tonikelope/multimetreitor/Rainmeter/Multimetreitor/@Resources/rayo.png

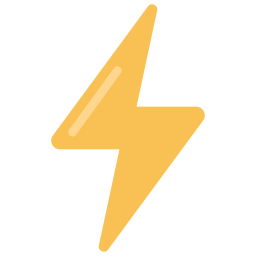
Rainmeter/Multimetreitor/@Resources/rayo.png
