tonikelope/multimetreitor/multimetreitor.ino

/**************************************************
 * MULTIMETREITOR
 **************************************************/

#include <ESP8266WiFi.h>
#include <ESP8266HTTPClient.h>
#include <WiFiClientSecure.h>
#include <PubSubClient.h>
#include <ESP8266WebServer.h>
#include <Wire.h>
#include <LiquidCrystal_I2C.h>
#include <EEPROM.h>
#include <LittleFS.h>   // DIAGNOSTIC (/fsinfo): probe the flash filesystem partition
#include <SoftwareSerial.h>
#include <PZEM004Tv30.h>
#include <ArduinoJson.h>
#include <ArduinoOTA.h>
#include <time.h>
#include <memory>
#include <stddef.h>  // offsetof (AppConfig layout static_asserts)
#include <ctype.h>   // isalnum (webhook URL encoding)
#include "secrets.h"  // WiFi credentials (not versioned — see secrets.h.example)

#ifndef TZ_INFO
// Peninsular Spain: CET with DST (last Sunday of March/October)
#define TZ_INFO "CET-1CEST,M3.5.0/2,M10.5.0/3"
#endif

const char MAIN_html[] PROGMEM = R"rawliteral(
<!DOCTYPE html>
<html>
<head>
  <meta charset='utf-8'>
  <meta name="viewport" content="width=device-width, initial-scale=1, shrink-to-fit=no">
  <title>MULTIMETREITOR</title>
  <style>
    body { font-family: 'Segoe UI', Arial, sans-serif; background: #f7f7fa; margin:0; }
    .main { max-width: 480px; background: #fff; margin: 24px auto; border-radius: 14px; box-shadow: 0 2px 16px #0001; padding: 30px 22px; }
    h1 { text-align:center; letter-spacing:2px; color:#224; margin-bottom:2px; }
    .byline { text-align:center; font-size:1em; color:#888; margin-bottom:16px;}
    .lcd-sim {
      width: calc(16ch + 1.8ch); max-width: 98vw; height: 3.2em;
      background: linear-gradient(180deg, #f7ffbf 60%, #b4ff99 100%);
      border: 3px solid #bb5; border-radius: 14px; margin: 0 auto 22px auto;
      display: flex; flex-direction: column; justify-content: center;
      box-shadow: 0 2px 12px #0002 inset;
      font-family: 'Fira Mono', 'Consolas', monospace; font-size: 1.16em; color: #111; letter-spacing: 0.8px;
      overflow: hidden; position: relative; padding-left: 0.5ch; padding-right: 0.5ch;
    }
    .lcd-row { height: 45%; line-height: 1.18em; white-space: pre; font-family: inherit; font-size: inherit; padding-left: 0; }
    .lcd-frame { position:absolute; border:2px solid #dc6; border-radius:12px; inset:0; pointer-events:none;}
    h2 { font-size:1.13em; color:#337; margin:18px 0 8px 0; border-bottom:1px solid #eef; }
    label, input[type=checkbox], input[type=radio] { cursor:pointer; }
    .section { margin-bottom: 20px; }
    .alert-row { display: flex; align-items: center; gap: 12px; margin-bottom:10px; }
    .alert-row input[type="number"] { width: 80px; }
    .pzem-spin { display:inline-flex; align-items:center; gap:6px; vertical-align:middle; }
    .pzem-spin input[type="number"] { width:92px; text-align:center; }
    .pzem-step { width:34px; height:34px; border:1px solid #bbf780; background:#eef7e2; color:#2b7a2b; border-radius:8px; font-size:1.3em; font-weight:bold; line-height:1; cursor:pointer; padding:0; }
    .pzem-step:hover { background:#e0efcd; }
    .pzem-step:active { transform:translateY(1px); }
    .alert-row .unit { margin-left:2px; color:#666; }
    .icp-group { background: #f7ffd7; border-radius:8px; padding:10px 14px; margin-bottom: 5px; border:1px solid #bbf780;}
    .icp-label { font-weight:bold; color:#2b4; }
    .icp-row { margin:4px 0 9px 0; }
    .icp-slider-label { margin-left:8px; font-size:0.97em; color:#397; }
    .icp-curve-table { margin-top:8px; width:98%; border-collapse:collapse; }
    .icp-curve-table th, .icp-curve-table td { border:1px solid #aae680; text-align:center; padding:3px 4px; }
    .icp-curve-table th { background:#eef; }
    .icp-curve-box-btn { margin-top:7px;background:#1e90ff;color:#fff;border-radius:6px;padding:5px 16px;border:none;cursor:pointer; }
    .desc { color:#555; font-size:0.98em; margin-bottom:7px; }
    .lcd-row-metrics { display: flex; flex-wrap:wrap; gap:8px; margin-bottom: 5px;}
    .lcd-row-metrics label { margin-right:7px; }
    input[type="number"], input[type="text"], input[type="range"] {
      width:85px; padding:4px; border-radius:6px; border:1px solid #ccd; margin-left:8px; font-size:1em;
    }
    input[type="range"] { width:120px; }
    .form-actions { display: flex; flex-direction: column; gap: 13px; margin-top: 25px; }
    .action-btn, input[type="submit"] {
      width: 100%;
      display: block;
      font-size: 1em;
      border-radius: 8px;
      border: none;
      color: #fff;
      padding: 13px 0;
      margin: 0;
      font-family: inherit;
      box-shadow: 0 1px 6px #0002;
      letter-spacing: 1px;
      cursor: pointer;
      transition: 0.18s;
    }
    .consumo-row {
      display: flex;
      align-items: center;
      gap: 12px;
      flex-wrap: wrap;
      margin-bottom: 8px;
    }
    .consumo-unidad {
      display: flex;
      align-items: center;
      gap: 6px;
    }
    .consumo-row input[type="number"] {
      width: 85px;
      margin-left: 0;
    }
    .action-btn.energy { background: #0ab06b; }
    .action-btn.energy:hover { background: #086c49; }
    .action-btn.eeprom { background: #ba00b4; }
    .action-btn.eeprom:hover { background: #7b006e; }
    .action-btn.reset { background: #f74; }
    .action-btn.reset:hover { background: #c33; }
    input[type="submit"] { background: #357aff; }
    input[type="submit"]:hover { background: #1c54b2; }
    .action-btn.io { background: #2f8fbf; }
    .action-btn.io:hover { background: #216d94; }
    .mqtt-section { margin-bottom:18px;}
    .topics-list { background:#f2f2f7; border:1px solid #ddd; border-radius:6px; padding:8px 10px; font-size:0.98em; color:#226; margin:7px 0 0 0;}
    .mqtt-status { font-weight:bold; margin-left:8px;}
    .mqtt-ok { color:#090; }
    .mqtt-fail { color:#c00; }
    @media (max-width:520px) {
      .main { padding:12px 2vw; }
      h1 { font-size:1.5em; }
      h2 { font-size:1em; }
      input[type="submit"], .action-btn { padding:9px 0; width:100%; }
      .lcd-row-metrics { flex-direction: column; gap:2px;}
      .desc { font-size:0.97em; }
      .lcd-sim { width: 98vw; max-width: calc(16ch + 1.8ch); font-size: 1.03em; }
    }
    .loader {
      display:inline-block;
      width:38px; height:38px;
      border:4px solid #f3f3f3;
      border-top:4px solid #357aff;
      border-radius:50%;
      animation: spin 1s linear infinite;
      margin-bottom:10px;
    }
    @keyframes spin {
      100% { transform: rotate(360deg); }
    }
    #lastResetTime { font-weight: bold; color: #1e90ff; }

    /* ===== Tabs ===== */
    .tabbar { display:flex; gap:4px; margin:4px 0 18px 0; border-bottom:2px solid #e6e9f2; }
    .tab-btn {
      flex:1; padding:10px 6px; border:none; background:none; color:#778; font-size:1em;
      font-family:inherit; cursor:pointer; border-bottom:3px solid transparent; margin-bottom:-2px;
      font-weight:bold; letter-spacing:0.4px; transition:0.15s;
    }
    .tab-btn.on { color:#357aff; border-bottom-color:#357aff; }
    .tab-btn:hover { color:#224; }
    .rules-nav { display:flex; align-items:center; justify-content:center; gap:14px; margin:2px 0 12px 0; }
    .rules-page-btn { background:#5566cc; color:#fff; border:none; border-radius:8px; width:40px; height:32px; font-size:1.2em; font-weight:bold; line-height:1; cursor:pointer; }
    .rules-page-btn:hover { background:#3a48a0; }
    .rules-page-btn:disabled { background:#b9c0d8; cursor:default; }
    .rules-page-ind { font-size:0.92em; font-weight:bold; color:#5566a0; min-width:54px; text-align:center; font-variant-numeric:tabular-nums; }

    /* ===== Rule engine editor ===== */
    .rules-intro { color:#555; font-size:0.97em; margin-bottom:12px; text-align:justify; }
    .rule-card {
      border:1px solid #d6dcf0; border-left:4px solid #357aff; border-radius:10px;
      background:#fbfcff; padding:12px 13px; margin-bottom:14px;
      box-shadow:0 1px 5px #0001;
    }
    .rule-card.disabled { border-left-color:#bbb; opacity:0.72; }
    .rule-head { display:flex; align-items:center; gap:9px; flex-wrap:wrap; margin-bottom:9px; }
    .rule-head .rule-num { flex:0 0 auto; width:23px; height:23px; border-radius:50%; background:#5566a0; color:#fff; font-size:0.82em; font-weight:bold; display:flex; align-items:center; justify-content:center; }
    .rule-head .rname { flex:1 1 130px; min-width:110px; margin-left:0; }
    .rule-head .sw { display:flex; align-items:center; gap:5px; font-size:0.92em; color:#456; }
    .rule-del {
      background:#f4f6fb; color:#c33; border:1px solid #e2b6b6; border-radius:6px;
      width:30px; height:30px; font-size:1.1em; line-height:1; cursor:pointer; padding:0;
    }
    .rule-del:hover { background:#fde7e7; }
    .rule-block { background:#fff; border:1px solid #e7ebf5; border-radius:8px; padding:9px 10px; margin-bottom:9px; }
    .rule-block > .lbl { font-size:0.82em; text-transform:uppercase; letter-spacing:0.5px; color:#8894ad; font-weight:bold; margin-bottom:6px; }
    .rule-count { font-weight:normal; letter-spacing:0; color:#aab4c8; }
    .rule-count.full { color:#c88a56; }
    .cond-row { display:flex; align-items:center; gap:6px; flex-wrap:wrap; margin-bottom:6px; }
    .cond-row select, .cond-row input[type=number] { margin-left:0; }
    .cond-row .metric { min-width:120px; }
    .cond-row .op { width:56px; text-align:center; }
    .cond-row .cval { width:88px; }
    .cond-row .unit { color:#789; font-size:0.9em; min-width:32px; }
    .cond-del { background:none; border:none; color:#c55; cursor:pointer; font-size:1.05em; padding:2px 5px; }
    .cond-join { display:inline-flex; align-items:center; gap:6px; margin:2px 0 8px 2px; font-size:0.9em; color:#556; }
    .rule-mini-btn {
      background:#eef3ff; color:#2456c8; border:1px solid #c9d8f7; border-radius:6px;
      padding:4px 11px; font-size:0.9em; cursor:pointer; margin-top:2px;
    }
    .rule-mini-btn:hover { background:#dde8ff; }
    .action-tabs { display:flex; gap:6px; margin-bottom:9px; }
    .action-tabs button {
      flex:1; padding:7px 0; border:1px solid #c9d3ea; background:#f2f5fc; color:#456;
      border-radius:7px; cursor:pointer; font-size:0.94em; font-family:inherit;
    }
    .action-tabs button.on { background:#357aff; color:#fff; border-color:#357aff; font-weight:bold; }
    .rule-field { margin-bottom:8px; }
    .rule-field label { display:block; font-size:0.9em; color:#556; margin-bottom:3px; }
    .rule-field input[type=text] { width:100%; margin-left:0; box-sizing:border-box; }
    .rule-field-row { display:flex; gap:8px; flex-wrap:wrap; }
    .rule-field-row .rule-field { flex:1 1 130px; }
    .rule-opts { display:flex; gap:16px; flex-wrap:wrap; align-items:center; font-size:0.92em; color:#456; margin-top:4px; }
    .rule-opts label { display:inline-flex; align-items:center; gap:5px; }
    .rule-opts input[type=number] { width:60px; }
    .rule-test-btn { background:none; border:none; color:#2456c8; cursor:pointer; font-size:0.88em; text-decoration:underline; padding:0; margin-top:2px; }
    .rules-actions { display:flex; gap:10px; flex-wrap:wrap; margin-top:6px; }
    .rules-actions button { flex:1 1 140px; }
    .action-btn.rules-add { background:#5566cc; }
    .action-btn.rules-add:hover { background:#3a48a0; }
    .action-btn.rules-save { background:#0ab06b; }
    .action-btn.rules-save:hover { background:#086c49; }
    #rules-status { font-size:0.92em; margin-top:8px; min-height:1.2em; }
    #rules-status.ok { color:#0a8; } #rules-status.err { color:#c33; }
    .rule-action { border:1px dashed #cdd6ee; border-radius:8px; padding:8px 9px; margin-bottom:8px; background:#fcfdff; }
    .act-head { display:flex; align-items:center; gap:8px; margin-bottom:7px; }
    .act-num { font-size:0.8em; font-weight:bold; color:#8894ad; text-transform:uppercase; letter-spacing:0.5px; white-space:nowrap; }
    .act-head .action-tabs { flex:1; margin-bottom:0; }
    .act-del { background:none; border:none; color:#c55; cursor:pointer; font-size:1.05em; padding:2px 5px; line-height:1; }
    .rule-add-action { background:#eef3ff; color:#2456c8; border:1px solid #c9d8f7; border-radius:6px; padding:5px 12px; font-size:0.9em; cursor:pointer; margin-bottom:8px; }
    .rule-add-action:hover { background:#dde8ff; }
    .rule-foot { display:flex; align-items:center; gap:14px; flex-wrap:wrap; margin-top:2px; }
  </style>
</head>
<body>
  <div class='main' style="position:relative;">
    <button type="button" id="langBtn" onclick="toggleLang()" title="Language / Idioma" style="position:absolute;right:14px;top:14px;background:#eef;border:1px solid #ccd;border-radius:6px;padding:3px 10px;font-size:0.9em;cursor:pointer;">EN</button>
    <h1>MULTIMETREITOR</h1>
    <div class="byline">by tonikelope</div>
    <div class="lcd-sim" id="lcd-sim">
      <div class="lcd-row" id="lcd-row-1">&nbsp;</div>
      <div class="lcd-row" id="lcd-row-2">&nbsp;</div>
      <div class="lcd-frame"></div>
    </div>
    <div class="tabbar">
      <button type="button" class="tab-btn on" data-tab="alertas" onclick="showTab('alertas')" data-i18n="tabAlerts">Alertas</button>
      <button type="button" class="tab-btn" data-tab="rules" onclick="showTab('rules')" data-i18n="tabRules">Reglas</button>
      <button type="button" class="tab-btn" data-tab="consumo" onclick="showTab('consumo')" data-i18n="tabConsumo">Consumo</button>
      <button type="button" class="tab-btn" data-tab="config" onclick="showTab('config')" data-i18n="tabConfig">Config</button>
    </div>
    <form method='POST' onsubmit="return validateForm();">
      <div class="desc pane-config" style="display:none;margin-top:4px"><span data-i18n="refreshInterval">Intervalo de lectura PZEM (ms):</span> <span class="pzem-spin"><button type="button" class="pzem-step" onclick="stepPzem(-1)" aria-label="menos">&minus;</button><input type="number" id="pzemInt" min="500" max="60000" step="500" name="refresh_interval" value="%REFRESH_INTERVAL%" required><button type="button" class="pzem-step" onclick="stepPzem(1)" aria-label="mas">&plus;</button></span></div>
      <div class='mqtt-section pane-config' style="display:none">
        <h2 data-i18n="mqttBroker">Broker MQTT</h2>
        <label><span data-i18n="brokerIp">IP o nombre del broker MQTT:</span>
          <input type="text" name="mqtt_broker" value="%MQTT_BROKER%" pattern=".{7,31}" required style="width:190px;">
          <span id="mqtt-status">%MQTT_STATUS%</span>
        </label>
        <div class="desc"><span data-i18n="clientName">Nombre cliente MQTT:</span>
          <input type="text" name="mqtt_client" value="%MQTT_CLIENT%" maxlength="31" required style="width:150px;">
        </div>
        <div class="topics-list">
        <b data-i18n="topicsPublished">Topics donde se publica:</b>
        <ul style="margin:0 0 0 16px;padding:0;">
          <li>electricidad/casa/estado</li>
          <li>electricidad/casa/icp</li>
          <li>electricidad/casa/icp_evento</li>
          <li>electricidad/casa/alertas_config</li>
          <li>multimetreitor/status</li>
          <li>multimetreitor/serial</li>
        </ul>
        <div style="margin-top:7px;color:#357aff;font-size:0.97em;">
          <b>JSON:</b>
          <a href="http://%LOCAL_IP%/json" target="_blank">http://%LOCAL_IP%/json</a>
        </div>
      </div>
      </div>
      <div class='section pane-alertas'>
        <h2 data-i18n="alerts">Alertas</h2>
        <div class="alert-row">
          <label><input type="checkbox" name="alertaSonora" %ALERTA_SONORA%> <span data-i18n="soundAlert">Alerta sonora (buzzer)</span></label>
        </div>
        <div class="icp-group">
          <span class="icp-label" data-i18n="icpThermalAlert">Alerta ICP térmico</span><br>
          <div class="icp-row">
            <label><input type="checkbox" name="icpEnabled" %ICP_ENABLED%> <span data-i18n="enableIcp">Activar alerta ICP</span></label>
          </div>
          <div class="icp-row">
            <span data-i18n="nominalCurrent">Intensidad nominal:</span> <input type="number" step="0.1" min="5" max="80" name="icpNominal" value="%ICP_NOMINAL%"> A
          </div>
          <div class="icp-row">
            <span data-i18n="warnWindow">Margen de aviso:</span>
            <input type="number" min="15" max="1800" step="5" name="icpAvisoMax" id="icpAvisoMax" value="%ICP_AVISO%" style="width:80px;"> s
          </div>
          <div class="icp-row">
            <span data-i18n="heatThreshold">Umbral de aviso:</span>
            <input type="range" min="10" max="100" step="1" name="icpUmbral" value="%ICP_UMBRAL%" id="icpUmbralSlider" oninput="icpUmbralVal.value=value+'%';if(window.refreshAviso)refreshAviso()">
            <output id="icpUmbralVal">%ICP_UMBRAL%%</output>
            <div class="icp-slider-label" id="icpAvisoResumen"></div>
          </div>
          <button type="button" onclick="toggleCurve()" class="icp-curve-box-btn" data-i18n="adjustCurve">Ajustar curva de disparo</button>
          <div id="icp-curve-box" style="display:none;margin-top:13px;">
            <div class="icp-row">
              <b data-i18n="tripFromLabel">Sensibilidad del ICP:</b>
              <input type="range" min="0" max="100" step="1" name="icpSensibilidad" value="%ICP_SENS%" id="icpSensSlider" style="width:120px;vertical-align:middle;" oninput="icpSensVal.value=value+'%';if(window.refreshCurva)refreshCurva()">
              <output id="icpSensVal">%ICP_SENS%%</output>
              <div class="icp-slider-label"><span data-i18n="sensLow">lenta</span> &rarr; <span data-i18n="sensHigh">peor caso</span></div>
            </div>
            <input type="hidden" name="icpK" id="icpK" value="%ICP_K%">
            <input type="hidden" name="icpTau" id="icpTau" value="%ICP_TAU%">
            <input type="hidden" name="icpCooldown" id="icpCooldown" value="%COOLDOWN%">
            <table class="icp-curve-table" id="icpCurveTable">
              <tr><th data-i18n="ratioIN">Relación I/In</th><th data-i18n="tripAt">Salta en</th></tr>
            </table>
            <button type="button" onclick="restaurarCurva()" class="icp-curve-box-btn" style="background:#2b4;margin-top:13px;" data-i18n="restoreDefaults">Restaurar valores por defecto</button>
          </div>
          <div class="icp-row" style="margin-top:10px;">
            <a href="/icp_log" style="color:#1e90ff;text-decoration:none;font-weight:bold;" data-i18n="viewIcpLog">Ver historial de sobrecargas</a>
          </div>
        </div>
        <div class="consumo-row">
          <label><input type='checkbox' name='consumoEnabled' %CONSUMO_ENABLED%> <span data-i18n="currentPowerAlert">Alerta por <b>corriente/potencia</b></span></label>
          <span class="consumo-unidad">
            <input type='radio' name='consumoTipo' value='amperios' %CONSUMO_A%>A
            <input type='radio' name='consumoTipo' value='watios' %CONSUMO_W%>W
            <input type='number' id='consumoValor' step='0.1' min='0' max='10000' name='consumoValor' value='%CONSUMO_VALOR%' required>
          </span>
        </div>
        <div class='alert-row'>
          <label><input type='checkbox' name='sobretensionEnabled' %SOBRE_ENABLED%> <span data-i18n="overvoltageAlert">Alerta por <b>sobretensión</b></span></label>
          <input type='number' step='0.1' min='0' max='300' name='sobretensionValor' value='%SOBRE_VALOR%' required>
          <span class="unit">V</span>
        </div>
        <div class='alert-row'>
          <label><input type='checkbox' name='subtensionEnabled' %SUB_ENABLED%> <span data-i18n="undervoltageAlert">Alerta por <b>subtensión</b></span></label>
          <input type='number' step='0.1' min='0' max='300' name='subtensionValor' value='%SUB_VALOR%' required>
          <span class="unit">V</span>
        </div>
      </div>
      <div class="form-actions pane-alertas">
        <input type='submit' id="saveAlertsBtn" value='Guardar alertas'>
      </div>
      <div class='section pane-config' style="display:none">
        <h2>LCD</h2>
        <div class="desc" data-i18n="selectMetrics">Selecciona qué métricas quieres mostrar en pantalla:</div>
        <div class="lcd-row-metrics">
          <label><input type='checkbox' name='lcd_v' %LCD_VOLT%><span data-i18n="voltage">Voltaje</span></label>
          <label><input type='checkbox' name='lcd_f' %LCD_FREQ%><span data-i18n="frequency">Frecuencia</span></label>
          <label><input type='checkbox' name='lcd_i' %LCD_CURR%><span data-i18n="current">Corriente</span></label>
          <label><input type='checkbox' name='lcd_p' %LCD_POWR%><span data-i18n="power">Potencia</span></label>
          <label><input type='checkbox' name='lcd_e' %LCD_ENER%><span data-i18n="energy">Energía</span></label>
          <label><input type='checkbox' name='lcd_pf' %LCD_PF%><span data-i18n="powerFactor">Factor Potencia</span></label>
          <label><input type='checkbox' name='lcd_icp' %LCD_ICP%><span data-i18n="icp">ICP</span></label>
        </div>
      </div>
      <div class="desc pane-config" style="display:none"><span data-i18n="uptimeLabel">Uptime (desde el último reinicio):</span> <span id="uptimeVal">&hellip;</span></div>
      <div class="form-actions pane-config" style="display:none">
        <button type="button" onclick="doExportConfig()" class="action-btn io" data-i18n="exportCfg">Exportar configuraci&oacute;n</button>
        <button type="button" onclick="document.getElementById('cfgFile').click()" class="action-btn io" data-i18n="importCfg">Importar configuraci&oacute;n</button>
        <input type="file" id="cfgFile" accept=".json,application/json" style="display:none" onchange="doImportConfig(this)">
      </div>
      <div class="form-actions pane-config" style="display:none">
        <button type="button" onclick="wipeEEPROM()" class="action-btn eeprom" data-i18n="wipeMemory">Borrar memoria</button>
        <button type="button" onclick="resetDevice()" class="action-btn reset" data-i18n="resetDeviceBtn">Resetear dispositivo</button>
        <input type='submit' id="saveChangesBtn" value='Guardar cambios'>
      </div>
    </form>
    <div id="tab-consumo" style="display:none;">
      <iframe id="consumoFrame" data-src="/consumos" scrolling="no" onload="sizeConsumoFrame()" style="width:100%;border:0;min-height:420px;display:block;"></iframe>
    </div>
    <div class='section' id="tab-rules" style="display:none;">
      <h2 data-i18n="rulesTitle">&#9889; Reglas / Disparadores</h2>
      <div class="rules-intro" data-i18n="rulesIntro">Dispara acciones cuando se cumplen una o varias condiciones sobre las medidas (con persistencia anti-rebote). Cada regla puede publicar en un topic MQTT o llamar a una URL (webhook).</div>
      <div id="rules-nav" class="rules-nav" style="display:none;">
        <button type="button" id="rules-prev" class="rules-page-btn" onclick="rulesPage(-1)" title="Anterior">&#8249;</button>
        <span id="rules-page-ind" class="rules-page-ind"></span>
        <button type="button" id="rules-next" class="rules-page-btn" onclick="rulesPage(1)" title="Siguiente">&#8250;</button>
      </div>
      <div id="rules-list"></div>
      <div class="rules-actions">
        <button type="button" class="action-btn rules-add" onclick="rulesAdd()" data-i18n="ruleAdd">&#43; A&ntilde;adir regla</button>
        <button type="button" class="action-btn rules-save" onclick="rulesSave()" data-i18n="ruleSave">&#128190; Guardar reglas</button>
      </div>
      <div id="rules-status"></div>
    </div>
  </div>
  <script>
    var CURRENT_LANG = 'es';
    var I18N = {
      es: {
        mqttBroker:"Broker MQTT", brokerIp:"IP o nombre del broker MQTT:", clientName:"Nombre cliente MQTT:",
        refreshInterval:"Intervalo de lectura PZEM (ms):", topicsPublished:"Topics donde se publica:",
        alerts:"Alertas", soundAlert:"Alerta sonora (buzzer)", icpThermalAlert:"Alerta ICP térmico",
        enableIcp:"Activar alerta ICP", nominalCurrent:"Intensidad nominal:", heatThreshold:"Umbral de aviso:",
        warnWindow:"Margen de aviso:",
        warnMeans:"Te avisará cuando queden {s} s o menos para el salto.",
        adjustCurve:"Ajustar curva de disparo", ratioIN:"Relación I/In",
        neverTrips:"nunca salta",
        tripAt:"Salta en", sensLow:"lenta", sensHigh:"peor caso",
        tripFromLabel:"Sensibilidad del ICP:",
        restoreDefaults:"Restaurar valores por defecto", currentPowerAlert:"Alerta por <b>corriente/potencia</b>",
        overvoltageAlert:"Alerta por <b>sobretensión</b>", undervoltageAlert:"Alerta por <b>subtensión</b>",
        selectMetrics:"Selecciona qué métricas quieres mostrar en pantalla:", voltage:"Voltaje",
        frequency:"Frecuencia", current:"Corriente", power:"Potencia", energy:"Energía",
        powerFactor:"Factor Potencia", icp:"ICP", viewIcpLog:"Ver historial de sobrecargas",
        logFromLevel:"Registrar en log desde nivel:", logOrAmp:"o corriente:",
        uptimeLabel:"Uptime (desde el último reinicio):", wipeMemory:"Borrar memoria", resetDeviceBtn:"Resetear dispositivo",
        saveChanges:"Guardar cambios", connected:"(CONECTADO)", disconnected:"(NO CONECTADO)",
        confirmWipe:"¿Seguro que quieres borrar por completo la EEPROM?\nEsto restaurará todos los valores de fábrica y perderás la configuración.",
        wipingEeprom:"Borrando EEPROM...", resettingDevice:"Reiniciando dispositivo...", checkNumbers:"Revisa los valores numéricos.",
        tabAlerts:"Alertas", tabConsumo:"Consumo", tabConfig:"Config", tabRules:"Reglas", saveAlerts:"Guardar alertas",
        exportCfg:"Exportar configuración", importCfg:"Importar configuración", importConfirm:"Importar sobrescribirá la configuración actual con la del archivo. ¿Continuar?", importOk:"Configuración importada.", importErr:"No se pudo importar el archivo.",
        rulesTitle:"&#9889; Reglas / Disparadores",
        rulesIntro:"Dispara acciones cuando se cumplen una o varias condiciones sobre las medidas (con persistencia anti-rebote). Cada regla puede publicar en un topic MQTT o llamar a una URL (webhook).",
        ruleAdd:"&#43; Añadir regla", ruleSave:"&#128190; Guardar reglas", rulesSaved:"Reglas guardadas.", rulesSaveErr:"Error al guardar las reglas.",
        rulesEmpty:"No hay reglas. Pulsa «Añadir regla» para crear una.", ruleName:"Nombre de la regla",
        ruleEnabled:"Activada", ruleWhen:"Cuando", ruleAddCond:"+ condición", ruleAllHint:"se cumplen TODAS", ruleAnyHint:"se cumple ALGUNA",
        ruleAnd:"Y (AND)", ruleOr:"O (OR)", ruleThen:"Entonces", ruleActMqtt:"Publicar MQTT", ruleActHook:"Webhook (URL)",
        ruleTopic:"Topic MQTT", ruleUrl:"URL", ruleFire:"Mensaje al activarse", ruleClear:"Mensaje al limpiarse (opcional)",
        ruleBody:"Cuerpo al activarse (opcional)", ruleBodyClear:"Cuerpo al limpiarse (opcional)",
        phOptional:"(opcional, dejar vacío = no hacer nada)",
        ruleRetain:"Retenido", rulePost:"POST", ruleSamples:"Persistencia (lecturas)", ruleTest:"Probar ahora",
        ruleMaxReached:"Máximo de reglas alcanzado.", ruleDelC:"Confirmar borrado de la regla",
        ruleActionN:"Acción", ruleAddAction:"+ añadir acción", ruleActMaxReached:"Máximo de acciones por regla.",
        opGt:"&gt;", opGe:"&ge;", opLt:"&lt;", opLe:"&le;", opEq:"="
      },
      en: {
        mqttBroker:"MQTT Broker", brokerIp:"MQTT broker IP or hostname:", clientName:"MQTT client name:",
        refreshInterval:"PZEM read interval (ms):", topicsPublished:"Topics published to:",
        alerts:"Alerts", soundAlert:"Sound alert (buzzer)", icpThermalAlert:"Thermal ICP alert",
        enableIcp:"Enable ICP alert", nominalCurrent:"Nominal current:", heatThreshold:"Warning threshold:",
        warnWindow:"Warning window:",
        warnMeans:"You will be warned when {s} s or less remain before the trip.",
        adjustCurve:"Adjust trip curve", ratioIN:"I/In ratio",
        neverTrips:"never trips",
        tripAt:"Trips in", sensLow:"slow", sensHigh:"worst case",
        tripFromLabel:"ICP sensitivity:",
        restoreDefaults:"Restore defaults", currentPowerAlert:"<b>Current/power</b> alert",
        overvoltageAlert:"<b>Overvoltage</b> alert", undervoltageAlert:"<b>Undervoltage</b> alert",
        selectMetrics:"Select which metrics to show on the display:", voltage:"Voltage",
        frequency:"Frequency", current:"Current", power:"Power", energy:"Energy",
        powerFactor:"Power Factor", icp:"ICP", viewIcpLog:"View overload history",
        logFromLevel:"Log episodes from level:", logOrAmp:"or current:",
        uptimeLabel:"Uptime (since last reboot):", wipeMemory:"Wipe memory", resetDeviceBtn:"Reset device",
        saveChanges:"Save changes", connected:"(CONNECTED)", disconnected:"(NOT CONNECTED)",
        confirmWipe:"Are you sure you want to completely wipe the EEPROM?\nThis will restore all factory defaults and you will lose the configuration.",
        wipingEeprom:"Wiping EEPROM...", resettingDevice:"Restarting device...", checkNumbers:"Please check the numeric values.",
        tabAlerts:"Alerts", tabConsumo:"Usage", tabConfig:"Config", tabRules:"Rules", saveAlerts:"Save alerts",
        exportCfg:"Export settings", importCfg:"Import settings", importConfirm:"Importing will overwrite the current settings with those in the file. Continue?", importOk:"Settings imported.", importErr:"Could not import the file.",
        rulesTitle:"&#9889; Rules / Triggers",
        rulesIntro:"Fire actions when one or more conditions on the measurements are met (with anti-bounce persistence). Each rule can publish to an MQTT topic or call a URL (webhook).",
        ruleAdd:"&#43; Add rule", ruleSave:"&#128190; Save rules", rulesSaved:"Rules saved.", rulesSaveErr:"Failed to save rules.",
        rulesEmpty:"No rules yet. Click \"Add rule\" to create one.", ruleName:"Rule name",
        ruleEnabled:"Enabled", ruleWhen:"When", ruleAddCond:"+ condition", ruleAllHint:"ALL are met", ruleAnyHint:"ANY is met",
        ruleAnd:"AND", ruleOr:"OR", ruleThen:"Then", ruleActMqtt:"Publish MQTT", ruleActHook:"Webhook (URL)",
        ruleTopic:"MQTT topic", ruleUrl:"URL", ruleFire:"Message on activate", ruleClear:"Message on clear (optional)",
        ruleBody:"Body on activate (optional)", ruleBodyClear:"Body on clear (optional)",
        phOptional:"(optional, leave empty = do nothing)",
        ruleRetain:"Retained", rulePost:"POST", ruleSamples:"Persistence (readings)", ruleTest:"Test now",
        ruleMaxReached:"Maximum number of rules reached.", ruleDelC:"Confirm deletion of rule",
        ruleActionN:"Action", ruleAddAction:"+ add action", ruleActMaxReached:"Maximum actions per rule.",
        opGt:"&gt;", opGe:"&ge;", opLt:"&lt;", opLe:"&le;", opEq:"="
      }
    };
    window.applyLang = function(lang){
      if(!I18N[lang]) lang='es';
      var d = I18N[lang];
      var els = document.querySelectorAll('[data-i18n]');
      for (var i=0;i<els.length;i++){
        var k = els[i].getAttribute('data-i18n');
        if (d[k] !== undefined) els[i].innerHTML = d[k];
      }
      var sc = document.getElementById('saveChangesBtn'); if(sc) sc.value = d.saveChanges;
      var sa = document.getElementById('saveAlertsBtn'); if(sa) sa.value = d.saveAlerts;
      var lb = document.getElementById('langBtn'); if(lb) lb.textContent = (lang==='es'?'EN':'ES');
      CURRENT_LANG = lang;
      document.documentElement.lang = lang;
      // Anything whose text the script writes has to be redrawn here: applyLang
      // only replaces elements carrying data-i18n, and these are built by JS.
      if (window.refreshCurva) window.refreshCurva();   // trip-time table
      if (window.refreshAviso) window.refreshAviso();   // "warns when N s are left"
      if (window.rulesRefreshLang) window.rulesRefreshLang();
      try { localStorage.setItem('mmt_lang', lang); } catch(e){}
    };
    window.toggleLang = function(){
      var nl = (CURRENT_LANG==='es'?'en':'es');
      applyLang(nl);                                  // translate the UI client-side (as before)
      try { fetch('/set_lang?lang='+nl); } catch(e){} // and persist it on the device (also drives the LCD)
    };
    // Same-origin iframe (both served by the device), so its content height can be
    // read directly to size the Consumo tab without an inner scrollbar.
    window.sizeConsumoFrame = function(){
      var f=document.getElementById('consumoFrame');
      try{ if(f&&f.contentWindow&&f.contentWindow.document.body){ f.style.height=(f.contentWindow.document.body.scrollHeight+24)+'px'; } }catch(e){}
    };
    window.showTab = function(name){
      // 'alertas' and 'config' panes share one <form> and are tagged by class so
      // every field always submits together; 'rules' and 'consumo' are their own blocks.
      var setDisp = function(sel, show){ var els=document.querySelectorAll(sel); for(var j=0;j<els.length;j++) els[j].style.display=(show?'':'none'); };
      setDisp('.pane-alertas', name==='alertas');
      setDisp('.pane-config', name==='config');
      var rules = document.getElementById('tab-rules'); if (rules) rules.style.display = (name==='rules' ? '' : 'none');
      var cons = document.getElementById('tab-consumo'); if (cons) cons.style.display = (name==='consumo' ? '' : 'none');
      if (name==='consumo'){ var fr=document.getElementById('consumoFrame'); if(fr && !fr.src){ fr.src=fr.getAttribute('data-src'); } setTimeout(sizeConsumoFrame,300); setTimeout(sizeConsumoFrame,1200); }
      var btns = document.querySelectorAll('.tab-btn');
      for (var i=0;i<btns.length;i++){ btns[i].classList.toggle('on', btns[i].getAttribute('data-tab')===name); }
    };
    window.stepPzem = function(dir){
      var el = document.getElementById('pzemInt'); if(!el) return;
      var v = parseInt(el.value, 10); if(isNaN(v)) v = 500;
      v += dir * 500;
      if(v < 500) v = 500; if(v > 60000) v = 60000;
      el.value = v;
    };
    window.doExportConfig = function(){ window.location = '/export'; };
    window.doImportConfig = function(inp){
      var f = inp.files && inp.files[0]; if(!f) return;
      var d = I18N[CURRENT_LANG] || I18N.es;
      if(!confirm(d.importConfirm)){ inp.value=''; return; }
      var rd = new FileReader();
      rd.onload = function(){
        fetch('/import', {method:'POST', headers:{'Content-Type':'application/json'}, body:rd.result})
          .then(function(r){ return r.json(); })
          .then(function(j){ if(j&&j.ok){ alert(d.importOk); location.reload(); } else { alert(d.importErr); } })
          .catch(function(){ alert(d.importErr); });
        inp.value='';
      };
      rd.readAsText(f);
    };
    document.addEventListener('DOMContentLoaded', function() {
      // Match the alert spinner to useful configuration precision. The PZEM may
      // report hundredths of an amp, but threshold arrows in hundredths are too
      // slow; power thresholds are more naturally adjusted in whole watts.
      var consumoInp = document.getElementById('consumoValor');
      var consumoTipos = document.querySelectorAll('input[name="consumoTipo"]');
      var syncConsumoStep = function(roundValue) {
        if (!consumoInp) return;
        var amperios = document.querySelector('input[name="consumoTipo"][value="amperios"]:checked');
        var step = amperios ? 0.1 : 1;
        consumoInp.step = String(step);
        if (roundValue && consumoInp.value !== '' && !isNaN(consumoInp.value)) {
          var n = Math.round(Number(consumoInp.value) / step) * step;
          consumoInp.value = amperios ? n.toFixed(1) : n.toFixed(0);
        }
      };
      syncConsumoStep(false);
      for (var ct=0;ct<consumoTipos.length;ct++) consumoTipos[ct].addEventListener('change', function(){ syncConsumoStep(true); });

      // The device-saved language (rendered server-side) is the source of truth,
      // so a fresh browser loads the language stored on the device.
      applyLang('%LANG%'==='en'?'en':'es');
       function updateUptime() {
        fetch('/uptime')
          .then(r => r.text())
          .then(t => {
            var e = document.getElementById('uptimeVal');
            if (e) e.textContent = t;
          }).catch(function(){});
      }
      setInterval(updateUptime, 15000);
      updateUptime();

      window.toggleCurve = function() {
        var box = document.getElementById('icp-curve-box');
        box.style.display = (box.style.display == 'none' || box.style.display == '') ? 'block' : 'none';
      };

      // Sensitivity selector model: k and tau are fixed (hidden inputs), fitted to
      // the slow branch of the catalogue curve (tau = 449/k^2.3 ties them). The only
      // control is icpSensibilidad (0-100 %): it slides the assumed thermal preload
      // from the slow branch (0) to the fast/worst-case branch (100), spanning the
      // whole band with one knob. ICP_SENS_FLOOR_MAX must match the firmware constant.
      //
      // That preload is what the firmware assumes at boot, when the breaker's
      // thermal state is genuinely unknown. Once it has been integrating measured
      // current there is a real thermal history and the model uses it instead, so
      // this table is the catalogue curve from a cold-ish start, not a promise
      // about a breaker that has been running warm for hours.
      var ICP_SENS_FLOOR_MAX = 0.922;
      function nominalVal() {
        var n = document.querySelector('input[name="icpNominal"]');
        var v = n ? parseFloat(n.value) : NaN;
        return (isNaN(v) || v <= 0) ? 25 : v;
      }
      window.restaurarCurva = function() {
        var s = document.getElementById('icpSensSlider');
        if (s) s.value = 100;                       // worst case = the safe default
        var o = document.getElementById('icpSensVal');
        if (o) o.value = '100%';
        refreshCurva();
      };

      // Trip time from the model: t = tau*ln((Heq - floor)/(Heq - 1)), Heq=(m/k)^2,
      // where floor is the assumed preload thermal state (0..<1) set by the
      // selector. Same math as the firmware, so the table shows what the device does.
      function tripTime(m, k, tau, floor) {
        var heq = (m * m) / (k * k);
        if (heq <= 1) return null;
        if (floor >= 1) floor = 0.999;
        var num = heq - floor, den = heq - 1;
        if (den <= 0 || num <= 0) return null;
        return tau * Math.log(num / den);
      }
      function fmtSecs(t) {
        var d = I18N[CURRENT_LANG] || I18N.es;
        if (t === null) return d.neverTrips;
        if (t < 60) return t.toFixed(t < 10 ? 1 : 0) + ' s';
        return (t / 60).toFixed(1) + ' min';
      }
      window.refreshCurva = function() {
        var k = parseFloat(document.getElementById('icpK').value);
        var tau = parseFloat(document.getElementById('icpTau').value);
        var sEl = document.getElementById('icpSensSlider');
        var sens = sEl ? parseFloat(sEl.value) : 100;
        var oEl = document.getElementById('icpSensVal');
        if (oEl && !isNaN(sens)) oEl.value = sens + '%';
        var tbl = document.getElementById('icpCurveTable');
        if (!tbl) return;
        if (isNaN(k) || isNaN(tau) || isNaN(sens)) {  // being edited: blank the table
          while (tbl.rows.length > 1) tbl.deleteRow(1);
          return;
        }
        // The selector picks where in the band we sit: sens/100 of the maximum
        // preload floor. 0 = slow branch, 100 = fast (worst-case) branch.
        var floor = (sens / 100) * ICP_SENS_FLOOR_MAX;
        var nomEl = document.querySelector('input[name="icpNominal"]');
        var nom = nomEl ? parseFloat(nomEl.value) : NaN;
        while (tbl.rows.length > 1) tbl.deleteRow(1);
        var mults = [1.20, 1.45, 1.60, 2.00, 2.55, 3.00];
        for (var i = 0; i < mults.length; ++i) {
          var m = mults[i];
          var r = tbl.insertRow(-1);
          var lbl = m.toFixed(2);
          if (!isNaN(nom) && nom > 0) lbl += ' (' + (m * nom).toFixed(1) + ' A)';
          r.insertCell(-1).textContent = lbl;
          r.insertCell(-1).textContent = fmtSecs(tripTime(m, k, tau, floor));
        }
      };
      // The bar is the warning window counted down to the trip, linear in the
      // time left, so the threshold inverts to seconds exactly and with no
      // dependence on the current or on tau:
      //   t = window * (1 - threshold/100)
      // 40 % of 120 s is 72 s left. An earlier version needed an exponential
      // inverse here because the bar was a rescaled temperature; it was exact
      // algebra over a model that no longer described what the bar did, and
      // above ~1.24x In the figure shown was up to 6x the real margin.
      window.refreshAviso = function() {
        var el = document.getElementById('icpAvisoResumen');
        var win = parseFloat(document.getElementById('icpAvisoMax').value);
        var u = parseFloat(document.getElementById('icpUmbralSlider').value);
        if (!el || isNaN(win) || isNaN(u)) return;
        var d = I18N[CURRENT_LANG] || I18N.es;
        var left = Math.round(win * (1 - u / 100));
        if (!(left >= 0)) left = 0;
        el.textContent = d.warnMeans.replace('{s}', left);
      };
      refreshAviso();
      refreshCurva();
      var avisoInp = document.getElementById('icpAvisoMax');
      if (avisoInp) avisoInp.addEventListener('input', refreshAviso);
      var nomInp = document.querySelector('input[name="icpNominal"]');
      if (nomInp) nomInp.addEventListener('input', refreshCurva);

      function updateLCD() {
        fetch('/json_lcd').then(r=>r.json()).then(j=>{
          document.getElementById('lcd-row-1').textContent = j.lcd1;
          document.getElementById('lcd-row-2').textContent = j.lcd2;
        }).catch(_=>{
          document.getElementById('lcd-row-1').textContent = "";
          document.getElementById('lcd-row-2').textContent = "";
        });
      }
      setInterval(updateLCD, 1000);
      updateLCD();

      function updateMqttStatus() {
        fetch('/mqtt_status').then(r=>r.json()).then(j=>{
          let el = document.getElementById('mqtt-status');
          var cls = j.ok ? 'mqtt-ok' : 'mqtt-fail';
          var txt = I18N[CURRENT_LANG][j.ok ? 'connected' : 'disconnected'];
          el.innerHTML = '<span class="mqtt-status ' + cls + '">' + txt + '</span>';
        });
      }
      setInterval(updateMqttStatus, 1000);
      updateMqttStatus();

      window.wipeEEPROM = function() {
        if(confirm(I18N[CURRENT_LANG].confirmWipe)) {
            document.body.innerHTML = "<div style='margin-top:60px;text-align:center;font-family:sans-serif'><div class='loader'></div><h2>" + I18N[CURRENT_LANG].wipingEeprom + "</h2></div>";
            fetch('/wipe_eeprom', {method:'POST'}).then(_ => {
                const poll = setInterval(() => {
                    fetch('/json').then(r => {
                        if (r.ok) {
                            clearInterval(poll);
                            location.href = '/';
                        }
                    }).catch(() => { });
                }, 2000);
                setTimeout(() => {
                    clearInterval(poll);
                    location.href = '/';
                }, 30000);
            });
        }
    };

    window.resetDevice = function() {
        document.body.innerHTML = "<div style='margin-top:60px;text-align:center;font-family:sans-serif'><div class='loader'></div><h2>" + I18N[CURRENT_LANG].resettingDevice + "</h2></div>";
        fetch('/reset', {method:'POST'}).then(_ => {
            const poll = setInterval(() => {
                fetch('/json').then(r => {
                    if (r.ok) {
                        clearInterval(poll);
                        location.href = '/';
                    }
                }).catch(() => { });
            }, 2000);
            setTimeout(() => {
                clearInterval(poll);
                location.href = '/';
            }, 30000);
        });
    };
      window.validateForm = function() {
        // Rule values are persisted by their own Save button, not by this form.
        // Excluding them also prevents a legacy, more precise rule value from
        // blocking an unrelated alert/config save after spinner steps change.
        let nums = document.querySelectorAll('input[type=number]:not(.cval)');
        for (let i = 0; i < nums.length; ++i) {
          let n = nums[i].value;
          if(n === "" || isNaN(n) || Number(n)<0) {
            // The ICP inputs live inside a collapsible box: a browser cannot
            // report a validation error on a hidden control, so the form would
            // silently refuse to submit. Reveal the box before complaining.
            if (!nums[i].checkValidity || !nums[i].checkValidity()) revealIfHidden(nums[i]);
            alert(I18N[CURRENT_LANG].checkNumbers); return false;
          }
          if (nums[i].checkValidity && !nums[i].checkValidity()) revealIfHidden(nums[i]);
        }
        return true;
      };
      function revealIfHidden(el) {
        // If the field sits on a hidden tab, switch to it first so its error is visible.
        if (el.closest) {
          if (el.closest('.pane-config') && window.showTab) showTab('config');
          else if (el.closest('.pane-alertas') && window.showTab) showTab('alertas');
        }
        var box = document.getElementById('icp-curve-box');
        if (box && box.style.display === 'none' && box.contains(el)) box.style.display = 'block';
      }
    });
  </script>
  <script>
    // Wrapped in a named function expression on purpose: arduino-cli's ctags step
    // treats a bare top-level JS declaration inside this raw string as a C
    // prototype and injects #line markers that corrupt the JS. An assignment form
    // (var x = ...) is ignored by ctags, like the block above. Keep this comment
    // free of C-like signatures for the same reason.
    var rulesEditorInit = function(){
    // ===== Rule engine editor =====
    var RULES = [];
    var RULES_PAGE = 0;   // paginated editor: index of the single rule currently shown
    var RMAX = 16, RCONDS = 8;
    var RMETRICS = [
      {es:'Corriente', en:'Current', u:'A', step:0.1},
      {es:'Tensión', en:'Voltage', u:'V', step:0.1},
      {es:'Potencia', en:'Power', u:'W', step:1},
      {es:'Factor de potencia', en:'Power factor', u:'', step:0.01},
      {es:'Frecuencia', en:'Frequency', u:'Hz', step:0.1},
      {es:'Carga ICP', en:'ICP load', u:'%', step:1},
      {es:'Energía', en:'Energy', u:'kWh', step:0.01}
    ];
    var ROPS = ['&gt;','&ge;','&lt;','&le;','='];
    function rt(k){ var d=I18N[CURRENT_LANG]||I18N.es; return d[k]!==undefined?d[k]:(I18N.es[k]||k); }
    function resc(s){ return String(s==null?'':s).replace(/&/g,'&amp;').replace(/"/g,'&quot;').replace(/</g,'&lt;').replace(/>/g,'&gt;'); }
    function rMetricLabel(v){ var m=RMETRICS[v]||RMETRICS[0]; return CURRENT_LANG==='en'?m.en:m.es; }
    function rMetricUnit(v){ return (RMETRICS[v]||RMETRICS[0]).u; }
    function rMetricStep(v){ return (RMETRICS[v]||RMETRICS[0]).step; }
    var RACTS=4;
    function newAction(){ return {type:'mqtt',target:'',fire:'',clear:'',retain:true,post:false}; }
    function rulesNew(){ return {enabled:true,name:'',combine:'and',samples:3,conds:[{metric:0,op:1,value:0}],acts:[newAction()]}; }

    function rCondHTML(i,k,c,total){
      var mopts='';
      for(var m=0;m<RMETRICS.length;m++) mopts+='<option value="'+m+'"'+(m==c.metric?' selected':'')+'>'+resc(rMetricLabel(m))+'</option>';
      var oopts='';
      for(var o=0;o<ROPS.length;o++) oopts+='<option value="'+o+'"'+(o==c.op?' selected':'')+'>'+ROPS[o]+'</option>';
      var del = total>1 ? '<button type="button" class="cond-del" onclick="rulesDelCond('+i+','+k+')" title="x">&#10005;</button>' : '';
      return '<div class="cond-row">'
        + '<select class="metric" onchange="rulesMetricChanged(this)">'+mopts+'</select>'
        + '<select class="op">'+oopts+'</select>'
        + '<input type="number" step="'+rMetricStep(c.metric)+'" class="cval" value="'+resc(c.value)+'">'
        + '<span class="unit">'+resc(rMetricUnit(c.metric))+'</span>'
        + del + '</div>';
    }

    function rActionHTML(i,aIdx,act,total){
      var isHook = act.type==='webhook';
      var tabs='<div class="action-tabs">'
        + '<button type="button" class="'+(!isHook?'on':'')+'" onclick="rulesSetActionType('+i+','+aIdx+',\'mqtt\')">'+rt('ruleActMqtt')+'</button>'
        + '<button type="button" class="'+(isHook?'on':'')+'" onclick="rulesSetActionType('+i+','+aIdx+',\'webhook\')">'+rt('ruleActHook')+'</button>'
        + '</div>';
      var del = total>1 ? '<button type="button" class="act-del" onclick="rulesDelAction('+i+','+aIdx+')" title="x">&#10005;</button>' : '';
      var fields;
      if(!isHook){
        fields='<div class="rule-field"><label>'+rt('ruleTopic')+'</label><input type="text" class="act-target" maxlength="63" value="'+resc(act.target)+'" placeholder="cmnd/calentador/Power"></div>'
          +'<div class="rule-field-row">'
          +'<div class="rule-field"><label>'+rt('ruleFire')+'</label><input type="text" class="act-fire" maxlength="31" value="'+resc(act.fire)+'" placeholder="OFF"></div>'
          +'<div class="rule-field"><label>'+rt('ruleClear')+'</label><input type="text" class="act-clear" maxlength="31" value="'+resc(act.clear)+'" placeholder="'+rt('phOptional')+'"></div>'
          +'</div>'
          +'<div class="rule-opts"><label><input type="checkbox" class="act-retain"'+(act.retain?' checked':'')+'> '+rt('ruleRetain')+'</label></div>';
      } else {
        fields='<div class="rule-field"><label>'+rt('ruleUrl')+'</label><input type="text" class="act-target" maxlength="63" value="'+resc(act.target)+'" placeholder="http://192.168.1.x/..."></div>'
          +'<div class="rule-field-row">'
          +'<div class="rule-field"><label>'+rt('ruleBody')+'</label><input type="text" class="act-fire" maxlength="31" value="'+resc(act.fire)+'"></div>'
          +'<div class="rule-field"><label>'+rt('ruleBodyClear')+'</label><input type="text" class="act-clear" maxlength="31" value="'+resc(act.clear)+'"></div>'
          +'</div>'
          +'<div class="rule-opts"><label><input type="checkbox" class="act-post"'+(act.post?' checked':'')+'> '+rt('rulePost')+'</label></div>';
      }
      return '<div class="rule-action" data-a="'+aIdx+'">'
        + '<div class="act-head"><span class="act-num">'+rt('ruleActionN')+' '+(aIdx+1)+'</span>'+tabs+del+'</div>'
        + fields + '</div>';
    }

    function rCardHTML(i,r){
      var conds='';
      for(var k=0;k<r.conds.length;k++) conds+=rCondHTML(i,k,r.conds[k],r.conds.length);
      var combine='';
      if(r.conds.length>=2){
        combine='<span class="cond-join"><select class="combine">'
          +'<option value="and"'+(r.combine==='and'?' selected':'')+'>'+rt('ruleAnd')+'</option>'
          +'<option value="or"'+(r.combine==='or'?' selected':'')+'>'+rt('ruleOr')+'</option>'
          +'</select></span>';
      }
      var addCond = r.conds.length<RCONDS ? '<button type="button" class="rule-mini-btn" onclick="rulesAddCond('+i+')">'+rt('ruleAddCond')+'</button>' : '';
      var acts='';
      for(var a=0;a<r.acts.length;a++) acts+=rActionHTML(i,a,r.acts[a],r.acts.length);
      var addAct = r.acts.length<RACTS ? '<button type="button" class="rule-add-action" onclick="rulesAddAction('+i+')">'+rt('ruleAddAction')+'</button>' : '';
      return '<div class="rule-card'+(r.enabled?'':' disabled')+'" data-idx="'+i+'">'
        + '<div class="rule-head">'
        +   '<span class="rule-num">'+(i+1)+'</span>'
        +   '<input type="text" class="rname" maxlength="31" value="'+resc(r.name)+'" placeholder="'+rt('ruleName')+'">'
        +   '<label class="sw"><input type="checkbox" class="renabled"'+(r.enabled?' checked':'')+' onchange="rulesToggle('+i+')"> '+rt('ruleEnabled')+'</label>'
        +   '<button type="button" class="rule-del" onclick="rulesDel('+i+')" title="x">&#10005;</button>'
        + '</div>'
        + '<div class="rule-block"><div class="lbl">'+rt('ruleWhen')+' <span class="rule-count'+(r.conds.length>=RCONDS?' full':'')+'">'+r.conds.length+'/'+RCONDS+'</span></div>'+conds
        +   '<div style="display:flex;align-items:center;gap:10px;flex-wrap:wrap;margin-top:4px;">'+addCond+combine+'</div>'
        + '</div>'
        + '<div class="rule-block"><div class="lbl">'+rt('ruleThen')+' <span class="rule-count'+(r.acts.length>=RACTS?' full':'')+'">'+r.acts.length+'/'+RACTS+'</span></div>'+acts+addAct
        +   '<div class="rule-foot">'
        +     '<label>'+rt('ruleSamples')+' <input type="number" class="samples" min="1" max="20" value="'+(r.samples||3)+'"></label>'
        +     '<button type="button" class="rule-test-btn" onclick="rulesTest('+i+')">'+rt('ruleTest')+'</button>'
        +   '</div>'
        + '</div>'
        + '</div>';
    }

    function rulesRender(){
      var box=document.getElementById('rules-list');
      if(!box) return;
      var nav=document.getElementById('rules-nav');
      if(!RULES.length){
        box.innerHTML='<div class="rules-intro">'+rt('rulesEmpty')+'</div>';
        if(nav) nav.style.display='none';
        return;
      }
      if(RULES_PAGE<0) RULES_PAGE=0;
      if(RULES_PAGE>=RULES.length) RULES_PAGE=RULES.length-1;
      // Paginated: render only the current rule; Prev/Next move between them.
      box.innerHTML=rCardHTML(RULES_PAGE,RULES[RULES_PAGE]);
      if(nav){
        nav.style.display=(RULES.length>1?'flex':'none');
        var ind=document.getElementById('rules-page-ind');
        if(ind) ind.textContent=(RULES_PAGE+1)+' / '+RULES.length;
        var pv=document.getElementById('rules-prev'); if(pv) pv.disabled=(RULES_PAGE<=0);
        var nx=document.getElementById('rules-next'); if(nx) nx.disabled=(RULES_PAGE>=RULES.length-1);
      }
    }

    function rulesGather(){
      // Only the current page's card is in the DOM, so merge each visible card
      // back into RULES by its data-idx instead of rebuilding the whole array
      // (rebuilding would drop every rule not currently shown).
      var cards=document.querySelectorAll('#rules-list .rule-card');
      for(var c=0;c<cards.length;c++){
        var card=cards[c];
        var idx=parseInt(card.getAttribute('data-idx'),10);
        if(isNaN(idx)||idx<0||idx>=RULES.length) continue;
        var r=RULES[idx];
        var nEl=card.querySelector('.rname'); if(nEl) r.name=nEl.value.slice(0,15);
        var eEl=card.querySelector('.renabled'); if(eEl) r.enabled=eEl.checked;
        var cEl=card.querySelector('.combine'); if(cEl) r.combine=cEl.value;
        var conds=[];
        var rows=card.querySelectorAll('.cond-row');
        for(var j=0;j<rows.length;j++){
          conds.push({
            metric:parseInt(rows[j].querySelector('.metric').value,10)||0,
            op:parseInt(rows[j].querySelector('.op').value,10)||0,
            value:parseFloat(rows[j].querySelector('.cval').value)||0
          });
        }
        if(conds.length) r.conds=conds;
        var acts=[];
        var actEls=card.querySelectorAll('.rule-action');
        for(var a=0;a<actEls.length;a++){
          var ae=actEls[a];
          var base=(r.acts&&r.acts[a])?r.acts[a]:newAction();
          var tgt=ae.querySelector('.act-target'); if(tgt) base.target=tgt.value;
          var fr=ae.querySelector('.act-fire'); if(fr) base.fire=fr.value;
          var cl=ae.querySelector('.act-clear'); if(cl) base.clear=cl.value;
          var rtEl=ae.querySelector('.act-retain'); if(rtEl) base.retain=rtEl.checked;
          var pEl=ae.querySelector('.act-post'); if(pEl) base.post=pEl.checked;
          acts.push(base);
        }
        if(acts.length) r.acts=acts;
        var sEl=card.querySelector('.samples'); if(sEl) r.samples=Math.max(1,Math.min(20,parseInt(sEl.value,10)||3));
        RULES[idx]=r;
      }
    }

    window.rulesMetricChanged=function(sel){
      var row=sel.closest('.cond-row'); if(!row) return;
      var metric=parseInt(sel.value,10)||0;
      var u=row.querySelector('.unit'); if(u) u.innerHTML=resc(rMetricUnit(metric));
      var v=row.querySelector('.cval'); if(v) v.step=String(rMetricStep(metric));
    };
    window.rulesToggle=function(i){ rulesGather(); rulesRender(); };
    window.rulesPage=function(delta){ rulesGather(); RULES_PAGE=Math.max(0,Math.min(RULES.length-1,RULES_PAGE+delta)); rulesRender(); };
    window.rulesAdd=function(){ rulesGather(); if(RULES.length>=RMAX){ rulesStatus(rt('ruleMaxReached'),'err'); return; } RULES.push(rulesNew()); RULES_PAGE=RULES.length-1; rulesRender(); };
    window.rulesDel=function(i){ rulesGather(); if(!confirm(rt('ruleDelC')+' #'+(i+1)+'?')) return; RULES.splice(i,1); if(RULES_PAGE>i) RULES_PAGE--; rulesRender(); };
    window.rulesAddCond=function(i){ rulesGather(); if(RULES[i]&&RULES[i].conds.length<RCONDS){ RULES[i].conds.push({metric:0,op:1,value:0}); rulesRender(); } };
    window.rulesDelCond=function(i,k){ rulesGather(); if(RULES[i]){ RULES[i].conds.splice(k,1); if(!RULES[i].conds.length) RULES[i].conds.push({metric:0,op:1,value:0}); rulesRender(); } };
    window.rulesAddAction=function(i){ rulesGather(); if(RULES[i]){ if(RULES[i].acts.length<RACTS){ RULES[i].acts.push(newAction()); rulesRender(); } else { rulesStatus(rt('ruleActMaxReached'),'err'); } } };
    window.rulesDelAction=function(i,a){ rulesGather(); if(RULES[i]){ RULES[i].acts.splice(a,1); if(!RULES[i].acts.length) RULES[i].acts.push(newAction()); rulesRender(); } };
    window.rulesSetActionType=function(i,a,t){ rulesGather(); if(RULES[i]&&RULES[i].acts[a]){ RULES[i].acts[a].type=t; rulesRender(); } };
    window.rulesRefreshLang=function(){ if(!document.getElementById('rules-list')) return; rulesGather(); rulesRender(); };

    function rulesStatus(msg,cls){ var s=document.getElementById('rules-status'); if(!s) return; s.textContent=msg; s.className=cls||''; }

    window.rulesSave=function(){
      rulesGather();
      return fetch('/save_rules',{method:'POST',headers:{'Content-Type':'application/json'},body:JSON.stringify(RULES)})
        .then(function(r){ return r.json(); })
        .then(function(j){ if(j&&j.ok){ rulesStatus(rt('rulesSaved'),'ok'); } else { rulesStatus(rt('rulesSaveErr'),'err'); } return j; })
        .catch(function(){ rulesStatus(rt('rulesSaveErr'),'err'); return {ok:false}; });
    };
    window.rulesTest=function(i){
      rulesGather();
      var r=RULES[i]; if(!r) return;
      var anyT=false; for(var a=0;a<r.acts.length;a++) if(r.acts[a].target) anyT=true;
      if(!anyT){ rulesStatus('#'+(i+1)+' ?','err'); return; }
      fetch('/rule_test',{method:'POST',headers:{'Content-Type':'application/json'},body:JSON.stringify(r)})
        .then(function(x){return x.json();})
        .then(function(x){
          if(!x||!x.ok){ rulesStatus('#'+(i+1)+' -','err'); return; }
          var res=x.results||[], parts=[], okAll=true;
          for(var a=0;a<res.length;a++){
            var rr=res[a]||{};
            if(rr.skipped){ parts.push('a'+(a+1)+':-'); }
            else if(rr.type==='mqtt'){ parts.push('a'+(a+1)+':MQTT '+(rr.ok?'OK':'x')); if(!rr.ok) okAll=false; }
            else { var good=(rr.code>0&&rr.code<400); parts.push('a'+(a+1)+':HTTP '+rr.code); if(!good) okAll=false; }
          }
          rulesStatus('#'+(i+1)+' '+parts.join('  '), okAll?'ok':'err');
        })
        .catch(function(){ rulesStatus(rt('rulesSaveErr'),'err'); });
    };

    function rulesLoad(){
      fetch('/json_rules').then(function(r){ return r.json(); }).then(function(arr){
        RULES=[];
        if(Array.isArray(arr)){
          for(var i=0;i<arr.length;i++){
            var o=arr[i]||{};
            var hasActs=o.acts&&o.acts.length;
            if(!o.enabled && !(o.conds&&o.conds.length) && !hasActs) continue; // skip empty slots
            var acts=[];
            if(hasActs){ for(var a=0;a<o.acts.length;a++){ var ao=o.acts[a]||{}; acts.push({type:ao.type==='webhook'?'webhook':'mqtt',target:ao.target||'',fire:ao.fire||'',clear:ao.clear||'',retain:!!ao.retain,post:!!ao.post}); } }
            if(!acts.length) acts=[newAction()];
            RULES.push({
              enabled:!!o.enabled, name:o.name||'', combine:o.combine==='or'?'or':'and',
              samples:o.samples||3, conds:(o.conds&&o.conds.length)?o.conds:[{metric:0,op:1,value:0}],
              acts:acts
            });
          }
        }
        rulesRender();
      }).catch(function(){ rulesRender(); });
    }
    document.addEventListener('DOMContentLoaded', rulesLoad);
    };
    rulesEditorInit();
  </script>
</body>
</html>
)rawliteral";

// ICP overload-history viewer. Static except for %LANG% (expanded by the shared
// template streamer); the table is built in the browser from /json_icp_log, so
// nothing here runs on the measurement path.
const char ICPLOG_html[] PROGMEM = R"rawliteral(
<!DOCTYPE html>
<html>
<head>
  <meta charset='utf-8'>
  <meta name="viewport" content="width=device-width, initial-scale=1, shrink-to-fit=no">
  <title>ICP LOG</title>
  <style>
    *{box-sizing:border-box;}
    body{font-family:'Segoe UI',system-ui,Arial,sans-serif;background:#eef3e6;color:#223;margin:0;padding:18px;}
    .wrap{max-width:840px;margin:0 auto;}
    .top{display:flex;align-items:center;justify-content:space-between;gap:12px;flex-wrap:wrap;}
    h1{font-size:1.32em;color:#337;margin:0;}
    a.back{display:inline-block;color:#1e90ff;text-decoration:none;font-weight:bold;font-size:0.95em;margin:0;}
    button.refresh{background:#1e90ff;color:#fff;border:none;border-radius:7px;padding:7px 16px;cursor:pointer;font-size:0.9em;}
    button.refresh:active{transform:translateY(1px);}
    .sub{color:#678;font-size:0.9em;margin:2px 0 6px 0;}
    .note{color:#7a6320;background:#fcf8e3;border:1px solid #f3e59a;border-radius:8px;padding:7px 11px;font-size:0.85em;margin:0 0 14px 0;}
    .card{background:#fff;border:1px solid #bbf780;border-radius:13px;padding:4px 6px;box-shadow:0 2px 12px #0001;overflow-x:auto;}
    table{width:100%;border-collapse:collapse;font-size:0.95em;}
    th{background:#f7ffd7;color:#2b4;text-align:left;padding:10px 11px;font-weight:700;border-bottom:2px solid #bbf780;white-space:nowrap;cursor:pointer;user-select:none;}
    th:hover{background:#eef7c8;}
    th .arr{color:#7aa;font-size:0.82em;margin-left:5px;}
    td{padding:10px 11px;border-bottom:1px solid #eef2ea;vertical-align:middle;white-space:nowrap;}
    tr:last-child td{border-bottom:none;}
    tbody tr.trip{background:#fff3f3;}
    tbody tr:hover{background:#fbfff2;}
    tbody tr.trip:hover{background:#ffecec;}
    .peak{font-variant-numeric:tabular-nums;font-weight:600;}
    .bar{display:flex;align-items:center;gap:9px;min-width:130px;}
    .track{flex:1;height:9px;background:#e9eef0;border-radius:6px;overflow:hidden;}
    .fill{height:100%;border-radius:6px;transition:width .3s;}
    .lvl{font-variant-numeric:tabular-nums;color:#556;width:40px;text-align:right;}
    .badge{display:inline-block;background:#e23;color:#fff;border-radius:20px;padding:2px 11px;font-size:0.8em;font-weight:700;letter-spacing:0.5px;}
    .dash{color:#9ab;}
    .empty{text-align:center;color:#789;padding:34px 10px;font-size:1.02em;}
  </style>
</head>
<body>
  <div class="wrap">
    <div class="top">
      <a class="back" id="back" href="/">&larr; Volver</a>
      <button class="refresh" id="refresh" onclick="load()">Actualizar</button>
    </div>
    <h1 id="title" style="margin:12px 0 2px 0">Historial de sobrecargas ICP</h1>
    <p class="sub" id="sub"></p>
    <p class="note" id="note" style="display:none"></p>
    <div class="card"><div id="content"><div class="empty">&hellip;</div></div></div>
  </div>
  <script>
    var LANG='%LANG%';
    var T={
      es:{title:'Historial de sobrecargas ICP',back:'← Volver',refresh:'Actualizar',
          thTime:'Fecha y hora',thDur:'Duración',thPeak:'Pico',thLevel:'Nivel máx.',thState:'Estado',
          trip:'SALTO',empty:'No hay episodios registrados.',
          sub:'Nominal {n} A · se registra desde {u} A · {c} episodios',
          cfgLabel:'Registrar desde nivel',cfgOr:'o pico',save:'Guardar',saved:'Guardado ✓',tripsKept:'Los saltos siempre se conservan.',
          noclock:'sin reloj',err:'Error al cargar el registro.'},
      en:{title:'ICP overload history',back:'← Back',refresh:'Refresh',
          thTime:'Date & time',thDur:'Duration',thPeak:'Peak',thLevel:'Max level',thState:'State',
          trip:'TRIP',empty:'No episodes recorded.',
          sub:'Nominal {n} A · recorded from {u} A · {c} episodes',
          cfgLabel:'Log from level',cfgOr:'or peak',save:'Save',saved:'Saved ✓',tripsKept:'Trips are always kept.',
          noclock:'no clock',err:'Failed to load the log.'}
    };
    var L=T[LANG]||T.es;
    var DATA=null, sortKey='ts', sortDir=-1;
    var COLS=[{k:'ts',lab:'thTime'},{k:'dur_s',lab:'thDur'},{k:'i_max_a',lab:'thPeak'},
              {k:'nivel_max',lab:'thLevel'},{k:'disparo',lab:'thState'}];
    function pad2(n){return (n<10?'0':'')+n;}
    function fmtDur(s){if(s<60)return s+'s';var m=Math.floor(s/60);return m+'m'+pad2(s%60)+'s';}
    function fmtTime(ts){if(!ts)return '<span class="dash">'+L.noclock+'</span>';
      var d=new Date(ts*1000);return d.toLocaleString(LANG==='es'?'es-ES':'en-GB');}
    function fillColor(n){var h=Math.round(120-1.2*n);if(h<0)h=0;return 'hsl('+h+',72%,45%)';}
    function num(x){return (typeof x==='number'&&isFinite(x))?x:0;}
    function val(e,k){return k==='disparo'?(e.disparo?1:0):num(e[k]);}
    function applyStatic(){
      document.getElementById('title').textContent=L.title;
      document.getElementById('back').textContent=L.back;
      document.getElementById('refresh').textContent=L.refresh;
    }
    function sortBy(k){ if(sortKey===k){sortDir=-sortDir;}else{sortKey=k;sortDir=-1;} draw(); }
    function draw(){
      var ev=(DATA&&DATA.eventos)?DATA.eventos.slice():[];
      ev.sort(function(a,b){var d=val(a,sortKey)-val(b,sortKey);if(d===0)d=num(a.ts)-num(b.ts);return sortDir*d;});
      var h='<table><thead><tr>';
      COLS.forEach(function(c){
        var arr=(sortKey===c.k)?'<span class="arr">'+(sortDir<0?'&#9660;':'&#9650;')+'</span>':'';
        h+='<th onclick="sortBy(\''+c.k+'\')">'+L[c.lab]+arr+'</th>';
      });
      h+='</tr></thead><tbody>';
      ev.forEach(function(e){
        var trip=!!e.disparo, n=num(e.nivel_max);
        h+='<tr class="'+(trip?'trip':'')+'">'
          +'<td>'+fmtTime(e.ts)+'</td>'
          +'<td>'+fmtDur(num(e.dur_s))+'</td>'
          +'<td class="peak">'+num(e.i_max_a).toFixed(2)+' A</td>'
          +'<td><div class="bar"><div class="track"><div class="fill" style="width:'+n+'%;background:'+fillColor(n)+'"></div></div><span class="lvl">'+n+'%</span></div></td>'
          +'<td>'+(trip?'<span class="badge">'+L.trip+'</span>':'<span class="dash">&mdash;</span>')+'</td>'
          +'</tr>';
      });
      h+='</tbody></table>';
      document.getElementById('content').innerHTML=h;
    }
    function render(j){
      DATA=j;
      var ev=(j&&j.eventos)?j.eventos:[];
      document.getElementById('sub').textContent=L.sub
        .replace('{n}',num(j.nominal).toFixed(0))
        .replace('{u}',num(j.umbral_registro_a).toFixed(2))
        .replace('{c}',ev.length);
      var nt=document.getElementById('note');
      if(j&&j.umbral_nivel!==undefined){
        var am=(j.umbral_amp!==undefined?j.umbral_amp:0);
        nt.innerHTML=L.cfgLabel
          +' <input id="cfgN" type="number" min="0" max="100" step="1" value="'+j.umbral_nivel+'" style="width:50px">%'
          +' '+L.cfgOr+' <input id="cfgA" type="number" min="0" max="100" step="0.5" value="'+am+'" style="width:58px">A'
          +' <button type="button" onclick="saveCfg()" style="margin-left:5px;background:#1e90ff;color:#fff;border:none;border-radius:6px;padding:3px 11px;cursor:pointer;font-size:.86em">'+L.save+'</button>'
          +' <span id="cfgMsg" style="color:#2b7a2b;font-weight:600"></span><br>'+L.tripsKept;
        nt.style.display='';
      }
      else{nt.style.display='none';}
      if(!ev.length){document.getElementById('content').innerHTML='<div class="empty">'+L.empty+'</div>';return;}
      draw();
    }
    function showErr(){document.getElementById('content').innerHTML='<div class="empty">'+L.err+'</div>';}
    window.saveCfg=function(){
      var n=document.getElementById('cfgN').value, a=document.getElementById('cfgA').value;
      var m=document.getElementById('cfgMsg'); if(m)m.textContent='…';
      fetch('/save_icp_log_cfg',{method:'POST',headers:{'Content-Type':'application/x-www-form-urlencoded'},
        body:'nivel='+encodeURIComponent(n)+'&amp='+encodeURIComponent(a)})
        .then(function(r){return r.json();})
        .then(function(){ if(m)m.textContent=L.saved; setTimeout(load,700); })
        .catch(function(){ if(m)m.textContent='!'; });
    };
    function load(){
      document.getElementById('content').innerHTML='<div class="empty">&hellip;</div>';
      fetch('/json_icp_log',{cache:'no-store'}).then(function(r){return r.json();}).then(render).catch(showErr);
    }
    applyStatic();load();
  </script>
</body>
</html>
)rawliteral";

// Electricity-usage viewer. Static except for %LANG%; fetches /consumo (JSON) and
// draws monthly + daily bar charts in the browser, so nothing runs on the device
// beyond serving the page. Single series (kWh) → one accent colour, no legend,
// value on hover, current period highlighted.
const char CONSUMO_html[] PROGMEM = R"rawliteral(
<!DOCTYPE html>
<html>
<head>
  <meta charset='utf-8'>
  <meta name="viewport" content="width=device-width, initial-scale=1, shrink-to-fit=no">
  <title>CONSUMOS</title>
  <style>
    *{box-sizing:border-box;}
    body{font-family:'Segoe UI',system-ui,Arial,sans-serif;background:#eef3e6;color:#223;margin:0;padding:18px;}
    .wrap{max-width:920px;margin:0 auto;}
    .top{display:flex;align-items:center;justify-content:space-between;gap:12px;flex-wrap:wrap;}
    h1{font-size:1.34em;color:#337;margin:0;}
    a.back{display:inline-block;color:#1e90ff;text-decoration:none;font-weight:bold;font-size:0.95em;margin:0;}
    button.refresh{background:#1e90ff;color:#fff;border:none;border-radius:7px;padding:7px 16px;cursor:pointer;font-size:0.9em;}
    button.refresh:active{transform:translateY(1px);}
    .kpis{display:flex;gap:12px;flex-wrap:wrap;margin:14px 0;}
    .kpi{flex:1;min-width:150px;background:#fff;border:1px solid #bbf780;border-radius:12px;padding:11px 16px;box-shadow:0 2px 10px #0001;}
    .kpi .lbl{color:#789;font-size:0.74em;text-transform:uppercase;letter-spacing:.5px;}
    .kpi .val{font-size:1.55em;font-weight:700;color:#2b7a2b;font-variant-numeric:tabular-nums;}
    .kpi .val small{font-size:.5em;color:#89a;font-weight:600;margin-left:3px;}
    .card{background:#fff;border:1px solid #bbf780;border-radius:13px;padding:14px 16px 10px;box-shadow:0 2px 12px #0001;margin-bottom:16px;}
    .card h2{font-size:1.03em;color:#2b7a2b;margin:0 0 14px 0;}
    .chart{display:flex;align-items:flex-end;gap:5px;height:196px;overflow-x:auto;padding-top:28px;padding-bottom:16px;}   /* padding-bottom leaves room for the overlay h-scrollbar so it doesn't cover the x-axis labels */
    .bar{position:relative;flex:1 0 auto;min-width:15px;display:flex;flex-direction:column;justify-content:flex-end;align-items:center;cursor:default;}
    .bar .fill{position:relative;width:74%;max-width:34px;background:#3aa657;border-radius:4px 4px 0 0;min-height:2px;transition:height .3s,filter .1s;}
    .bar.cur .fill{background:#1e90ff;}
    .bar .lab{font-size:.71em;color:#789;margin-top:5px;white-space:nowrap;}
    .bar .val{position:absolute;bottom:100%;left:50%;transform:translateX(-50%);margin-bottom:3px;font-size:.66em;color:#223;font-weight:700;font-variant-numeric:tabular-nums;white-space:nowrap;opacity:0;transition:opacity .1s;pointer-events:none;}
    .bar:hover .fill{filter:brightness(1.1);}
    .bar:hover .val{opacity:1;}
    .bar.showval .val{opacity:1;}
    #chSearch .bar{min-width:36px;}   /* wider hour bars so the value above fits without overlapping */
    .empty{color:#89a;text-align:center;padding:26px 10px;font-size:1.02em;}
    @media (prefers-color-scheme: dark){
      body{background:#1a1e17;color:#dde8d6;}
      .card,.kpi{background:#242a20;border-color:#3c4d2c;box-shadow:none;}
      h1{color:#9cf;} .kpi .val{color:#84ce84;} .card h2{color:#84ce84;} .kpi .lbl{color:#9ab08e;}
      .bar .lab{color:#9ab08e;} .bar .fill{background:#43b061;} .bar .val{color:#e6efdf;}
    }
  </style>
</head>
<body>
  <div class="wrap">
    <div class="top">
      <a class="back" id="back" href="/">&larr; Volver</a>
      <div style="display:flex;gap:8px;">
        <button class="refresh" id="dl" onclick="location.href='/export_hist'">Descargar</button>
        <button class="refresh" id="refresh" onclick="load()">Actualizar</button>
      </div>
    </div>
    <h1 id="title" style="margin:12px 0 2px 0">Consumo eléctrico</h1>
    <div class="kpis" id="kpis"></div>
    <div class="card"><h2 id="hMonth">Consumo mensual</h2><div class="chart" id="chMonth"><div class="empty">&hellip;</div></div></div>
    <div class="card"><h2 id="hDay">Consumo diario</h2><div class="chart" id="chDay"><div class="empty">&hellip;</div></div></div>
    <div class="card">
      <h2 id="hSearch">Buscar un día</h2>
      <div style="margin:0 0 10px 0;font-size:0.92em;display:flex;align-items:center;gap:8px;flex-wrap:wrap">
        <span id="searchLbl">Ver un día:</span>
        <input type="date" id="dpick" onchange="pickDay()" style="padding:3px 6px;border:1px solid #bbf780;border-radius:6px;font-size:0.95em">
      </div>
      <div id="searchSums" style="display:flex;gap:8px 20px;flex-wrap:wrap;margin:0 0 12px 0;font-size:0.95em">
        <span id="sMonth"></span>
        <span id="sDay" style="font-weight:700"></span>
      </div>
      <div class="chart" id="chSearch"><div class="empty" id="searchHint">&hellip;</div></div>
    </div>
  </div>
  <script>
    var LANG='%LANG%';
    var DATA=null;
    var T={
      es:{title:'Consumo eléctrico',back:'← Volver',refresh:'Actualizar',dl:'Descargar',
          month:'Consumo mensual',day:'Consumo diario',
          search:'Buscar un día',searchPick:'Ver un día:',
          searchHint:'Elige un día para ver su consumo.',
          sumMonth:'Consumo total del mes: {v} kWh',sumDay:'Consumo de ese día: {v} kWh',
          hourNone:'Sin datos horarios para ese día.',
          kToday:'Hoy',kMonth:'Este mes',kAvg:'Media diaria',
          empty:'Sin datos todavía',err:'Error al cargar los consumos.',
          months:['ene','feb','mar','abr','may','jun','jul','ago','sep','oct','nov','dic'],
          monthsL:['enero','febrero','marzo','abril','mayo','junio','julio','agosto','septiembre','octubre','noviembre','diciembre']},
      en:{title:'Electricity usage',back:'← Back',refresh:'Refresh',dl:'Download',
          month:'Monthly usage',day:'Daily usage',
          search:'Search a day',searchPick:'View a day:',
          searchHint:'Pick a day to see its usage.',
          sumMonth:'Month total: {v} kWh',sumDay:'That day: {v} kWh',
          hourNone:'No hourly data for that day.',
          kToday:'Today',kMonth:'This month',kAvg:'Daily avg',
          empty:'No data yet',err:'Failed to load usage data.',
          months:['Jan','Feb','Mar','Apr','May','Jun','Jul','Aug','Sep','Oct','Nov','Dec'],
          monthsL:['January','February','March','April','May','June','July','August','September','October','November','December']}
    };
    var L=T[LANG]||T.es;
    function num(x){var v=parseFloat(x);return isFinite(v)?v:0;}
    function fmt(v){return (v>=100?v.toFixed(0):v.toFixed(v>=10?1:2));}
    function applyStatic(){
      document.getElementById('title').textContent=L.title;
      document.getElementById('back').textContent=L.back;
      document.getElementById('refresh').textContent=L.refresh;
      var dlb=document.getElementById('dl'); if(dlb) dlb.textContent=L.dl;
      // Embedded as the Consumo tab (inside an iframe): no Back button there.
      if(window.self!==window.top){ var bk=document.getElementById('back'); if(bk) bk.style.display='none'; }
      document.getElementById('hMonth').textContent=L.month;
      document.getElementById('hDay').textContent=L.day;
      document.getElementById('hSearch').textContent=L.search;
      document.getElementById('searchLbl').textContent=L.searchPick;
      document.getElementById('searchHint').textContent=L.searchHint;
    }
    function kpi(lbl,val){return '<div class="kpi"><div class="lbl">'+lbl+'</div><div class="val">'+val+' <small>kWh</small></div></div>';}
    function drawChart(el,items,showVals){
      if(!items.length){el.innerHTML='<div class="empty">'+L.empty+'</div>';return;}
      var max=0; items.forEach(function(it){if(it.v>max)max=it.v;}); if(max<=0)max=1;
      var h='';
      items.forEach(function(it){
        var px=Math.max(2,Math.round(it.v/max*140));
        var clk=it.click?' onclick="'+it.click+'" style="cursor:pointer"':'';
        h+='<div class="bar'+(it.cur?' cur':'')+((showVals&&it.v>0)?' showval':'')+'"'+clk+' title="'+it.lab+': '+fmt(it.v)+' kWh">'
          +'<div class="fill" style="height:'+px+'px"><span class="val">'+fmt(it.v)+'</span></div>'
          +'<div class="lab">'+it.lab+'</div></div>';
      });
      el.innerHTML=h;
    }
    function render(j){
      DATA=j;
      var cy=(j.mes_actual?+j.mes_actual.año:0), cm=(j.mes_actual?+j.mes_actual.mes:0);
      // Monthly: completed months (sorted by year, month) + the current month.
      var hist=(j.historial||[]).map(function(m){return {y:+m['año'],mo:+m.mes,v:num(m.consumo),cur:false};});
      hist.sort(function(a,b){return a.y-b.y||a.mo-b.mo;});
      var months=hist.map(function(m){return {v:m.v,lab:L.months[(m.mo-1)%12]+" '"+String(m.y).slice(2)};});
      var curMonthV=0;
      if(j.mes_actual){curMonthV=num(j.mes_actual.consumo);
        months.push({v:curMonthV,lab:L.months[(+j.mes_actual.mes-1)%12]+" '"+String(j.mes_actual['año']).slice(2),cur:true});}
      var elM=document.getElementById('chMonth'); drawChart(elM,months,months.length<=14); elM.scrollLeft=elM.scrollWidth; // start scrolled to the current month
      // Daily: recent DAYS_SHOWN completed days + today. Each bar drills into its hours.
      var dias=(j.diario||[]).filter(function(d){return !cm||(+d['año']===cy&&+d.mes===cm);}).map(function(d){return {v:num(d.kwh),lab:String(d.dia),cur:false,
        click:'drillDay('+(+d['año'])+','+(+d.mes)+','+(+d.dia)+')'};});
      var today=j.dia_actual?num(j.dia_actual.kwh):0;
      if(j.dia_actual){
        var ty=(j.mes_actual?+j.mes_actual['año']:0), tm=(j.mes_actual?+j.mes_actual.mes:0);
        dias.push({v:today,lab:String(j.dia_actual.dia),cur:true,click:'drillDay('+ty+','+tm+','+(+j.dia_actual.dia)+')'});
      }
      var elD=document.getElementById('chDay'); drawChart(elD,dias,dias.length<=16); elD.scrollLeft=elD.scrollWidth; // start scrolled to today
      if(cm){ document.getElementById('hDay').textContent=L.day+' - '+L.monthsL[cm-1]+' '+cy; }
      // KPIs
      var avg=0,cnt=0;(j.diario||[]).forEach(function(d){avg+=num(d.kwh);cnt++;}); avg=cnt?avg/cnt:0;
      document.getElementById('kpis').innerHTML=
        kpi(L.kToday,fmt(today))+kpi(L.kMonth,fmt(curMonthV))+kpi(L.kAvg,fmt(avg));
      // Search box: cap the picker at today and load today by default.
      var dp=document.getElementById('dpick'); if(dp&&j.dia_actual){ dp.max=cy+'-'+pad2(cm)+'-'+pad2(+j.dia_actual.dia); }
      if(j.dia_actual){ drillDay(cy,cm,+j.dia_actual.dia); }
    }
    function showErr(){document.getElementById('kpis').innerHTML='';document.getElementById('chMonth').innerHTML='<div class="empty">'+L.err+'</div>';document.getElementById('chDay').innerHTML='';}
    function pad2(n){return ('0'+n).slice(-2);}
    function monthTotal(y,m){
      if(DATA&&DATA.mes_actual&&+DATA.mes_actual.año===y&&+DATA.mes_actual.mes===m) return num(DATA.mes_actual.consumo);
      var h=(DATA&&DATA.historial)||[]; for(var i=0;i<h.length;i++){ if(+h[i].año===y&&+h[i].mes===m) return num(h[i].consumo); }
      return null;
    }
    window.drillDay=function(y,m,d){
      var el=document.getElementById('chSearch');
      el.innerHTML='<div class="empty">&hellip;</div>';
      var dp=document.getElementById('dpick'); if(dp) dp.value=y+'-'+pad2(m)+'-'+pad2(d);
      var mv=monthTotal(y,m); document.getElementById('sMonth').textContent=L.sumMonth.replace('{v}',mv==null?'-':fmt(mv));
      var sd=document.getElementById('sDay');
      fetch('/json_hours?y='+y+'&m='+m+'&d='+d,{cache:'no-store'}).then(function(r){return r.json();}).then(function(j){
        var horas=(j.horas||[]);
        if(!horas.length){ el.innerHTML='<div class="empty">'+L.hourNone+'</div>'; sd.textContent=L.sumDay.replace('{v}','0'); return; }
        var byH={},tot=0; horas.forEach(function(x){var v=num(x.kwh);byH[+x.hora]=v;tot+=v;});
        var items=[]; for(var k=0;k<24;k++){ items.push({v:(byH[k]!==undefined?byH[k]:0),lab:k+'h'}); }
        drawChart(el,items,true);
        sd.textContent=L.sumDay.replace('{v}',fmt(tot));
      }).catch(function(){ el.innerHTML='<div class="empty">'+L.err+'</div>'; });
    };
    window.pickDay=function(){
      var dp=document.getElementById('dpick'); if(!dp||!dp.value) return;
      var p=dp.value.split('-'); if(p.length===3) drillDay(+p[0],+p[1],+p[2]);
    };
    function load(){
      fetch('/consumo',{cache:'no-store'}).then(function(r){return r.json();}).then(render).catch(showErr);
    }
    // Keep the embedding Consumo tab (parent iframe) sized to our content as it grows.
    try{
      if(window.self!==window.top && window.ResizeObserver){
        new ResizeObserver(function(){ if(window.parent&&window.parent.sizeConsumoFrame) window.parent.sizeConsumoFrame(); }).observe(document.body);
      }
    }catch(e){}
    applyStatic();load();
  </script>
</body>
</html>
)rawliteral";

// ================== WIFI / OTA / NTP CONFIG ======================
const char* ssid = WIFI_SSID;
const char* password = WIFI_PASSWORD;
IPAddress local_ip(192, 168, 1, 24);
IPAddress gateway(192, 168, 1, 1);
IPAddress subnet(255, 255, 255, 0);
IPAddress dns(192, 168, 1, 1);

#define WIFI_HOSTNAME "multimetreitor"
#define OTA_HOSTNAME "multimetreitor-ota"
#define NTP_SERVER "pool.ntp.org"

// ================== TIMINGS ======================
#define WIFI_RETRY_INTERVAL_MS 10000
#define WIFI_COOLDOWN_INTERVAL_MS 30000
#define WIFI_SETUP_TIMEOUT_MS 20000UL  // per-phase boot connect wait (static, then DHCP); loop() keeps retrying after
// A retained message is delivered sub-second after subscribing; the timeout
// only fully elapses when there is nothing to recover, so keep it short.
#define ICP_RECOVER_TIMEOUT_MS 3000
// Upper bound for one integration step of the ICP thermal model. Large enough
// that a stalled loop still counts as real overload time, small enough that an
// NTP/millis anomaly cannot inject a huge jump.
#define ICP_MAX_DT_S 60.0f
// Conventional non-tripping current (UNE-EN 60898-1 / UNE 20317): below this
// multiple of In no breaker trips, whatever its tolerance branch. Used to arm
// the ICP alert so a steady legitimate load never raises one.
#define ICP_NEVER_TRIP_MULT 1.13f
#define NTP_WAIT_TIMEOUT_MS 30000
#define NTP_RESYNC_INTERVAL_MS 86400000UL
// If NTP never synced at boot (timestamp stuck at -1), retry this often instead of
// waiting a full resync interval, so the clock self-heals within a minute or two.
#define NTP_RETRY_AFTER_FAIL_MS 60000UL

// ================== BUZZER ======================
#define BUZZER_PIN D7
#define BUZZER_BEEP_MS 500
#define BUZZER_BEEP_PERIOD 1000

// ================== LCD METRIC IDs ==============
#define LCD_VOLT 0
#define LCD_CURR 1
#define LCD_POWR 2
#define LCD_ENER 3
#define LCD_PF 4
#define LCD_FREQ 5
#define LCD_ICP 6

// LCD message language (persisted in config.lcdLang, driven by the web UI toggle)
enum LcdLang : uint8_t { LANG_ES = 0, LANG_EN = 1 };

// ================== DEFAULTS ====================
#define DEF_MQTT_BROKER "192.168.1.5"
#define DEF_MQTT_CLIENT "multimetreitor"
#define DEF_REFRESH_MS 1000
#define DEF_ALERTA_SONORA true
#define DEF_LCD_MASK ((1 << LCD_VOLT) | (1 << LCD_CURR))
#define DEF_LCD_LANG LANG_ES   // default LCD/web message language: Spanish
#define DEF_ICP_ENABLED false
#define DEF_ICP_NOMINAL 25.0f
// Bar level at which the buzzer/LCD/MQTT alert fires. The bar spans the last
// DEF_ICP_AVISO_MAX seconds before the trip, so 50 % is "start beeping with
// about a minute left" — visual warning first, sound only when it matters.
#define DEF_ICP_UMBRAL 50
// Thermal-image model (IEC 60255-149). k and tau are fixed, fitted to the SLOW
// (best-case) branch of the user's UNE 20317 trip curve; the sensitivity selector
// (config.icpSensibilidad) then slides the assumed thermal preload from that slow
// branch up to the FAST (worst-case) branch, so a single control spans the whole
// catalogue band without ever touching k or tau.
#define DEF_ICP_K 1.07f
#define DEF_ICP_TAU 384
// How early the bar starts filling: it leaves 0 % when the modelled time to
// trip drops below this many seconds. The bar itself is the thermal level,
// rescaled onto that window (see icpNivelPeligro), so a threshold of 50 %
// warns with roughly half the window left.
#define DEF_ICP_AVISO_MAX 120
#define DEF_ICP_COOLDOWN 384           // tau2 = tau1 (= DEF_ICP_TAU): a first-order thermal body cools with
                                       // the same time constant it heats with (tau = C/hA, independent of
                                       // whether an internal source is present -- the source sets the
                                       // equilibrium, not the rate). The previous 1.5*tau1 made de-energized
                                       // cooling slower than heating with no catalogue basis (curves only
                                       // cover heating to trip); realigned to tau1, still conservative.
// ICP sensitivity selector (%). 0 = slow branch (relaxed), 100 = fast branch
// (worst case, warns earliest). Default 100 so it never warns late out of the box.
#define DEF_ICP_SENS 100
// Thermal preload floor assumed at 100 % sensitivity: 0.922 reproduces the fast
// branch of the UNE curve. The selector scales it linearly (sens/100 * this).
// Applies to the BOOT SEED only: once the model has been integrating real
// current there is a measured thermal history, and overriding it with an
// assumed preload is what used to make the bar ignore that history entirely.
static const float ICP_SENS_FLOOR_MAX = 0.922f;
#define DEF_CONSUMO_ENABLED false
#define DEF_CONSUMO_TIPO_A false
#define DEF_CONSUMO_VAL 0.0f
#define DEF_SOBRET_ENABLED false
#define DEF_SOBRET_VAL 0.0f
#define DEF_SUBT_ENABLED false
#define DEF_SUBT_VAL 0.0f

// ================== CONFIG META =================
#define CONFIG_MAGIC 0x47
#define CONFIG_VERSION 12
#define CONFIG_VERSION_V11 11   // previous schema (pre-cleanup layout); migrated once on upgrade

// ================== VALIDATION LIMITS ==========
static const unsigned long MIN_REFRESH_MS = 500, MAX_REFRESH_MS = 60000;
static const float MIN_ICP_NOMINAL_A = 5.0f, MAX_ICP_NOMINAL_A = 80.0f;
static const int MIN_ICP_UMBRAL = 10, MAX_ICP_UMBRAL = 100;
static const int MIN_ICP_COOLDOWN_S = 60, MAX_ICP_COOLDOWN_S = 7200;
static const float MIN_ICP_K = 1.05f, MAX_ICP_K = 1.50f;
static const int MIN_ICP_TAU_S = 10, MAX_ICP_TAU_S = 7200;
static const int MIN_ICP_AVISO_S = 15, MAX_ICP_AVISO_S = 1800;
static const int MIN_ICP_SENS = 0, MAX_ICP_SENS = 100;
static const float MIN_VOLTAGE_LIMIT = 0.0f, MAX_VOLTAGE_LIMIT = 300.0f;
static const float MAX_CONSUMO_VAL = 10000.0f;

// ================== RULE ENGINE ================
// User-configurable event triggers (a native replacement for the external
// calentador.py hysteresis controller). Each rule = 1..MAX_CONDS conditions
// combined with AND/OR, plus an action (publish MQTT topic or call a webhook)
// fired on the rising edge, and an optional action on the falling edge.
// Active rule limits (rules now live in a LittleFS file + a RAM array, not in the
// 4 KB EEPROM sector, so these are RAM-bound, not sector-bound). Sized from the
// measured free heap (~26 KB): 16 rules x ~640 B ~= 10 KB, leaving comfortable margin.
#define MAX_RULES 16
#define MAX_CONDS 8
#define MAX_ACTIONS 4
// Legacy limits: the shape of the OLD in-EEPROM rules table, kept ONLY to size the
// rules[] block inside AppConfigV11 so a deployed v11 config is read correctly on
// upgrade. Must stay at the old values so the v11 layout (and its static_asserts)
// is byte-for-byte unchanged.
#define MAX_RULES_LEGACY 6
#define MAX_CONDS_LEGACY 3
#define MAX_ACTIONS_LEGACY 2
#define RULES_FILE "/rules.bin"   // LittleFS: active rules, fixed-size records
#define RULES_MAGIC 0x53   // marks a rules table written by this firmware (0x53: multi-action layout)
#define ICP_MODEL_MAGIC 0x72  // marks thermal-image ICP parameters written by this firmware
                              // (0x72: cooldown default realigned from 1.5*tau1 to tau1)

// ================== ICP FORENSIC LOG ===========
// The manufacturer's envelope spans a factor ~80 in trip time, so no catalogue
// can say where this particular breaker sits inside it. Only the breaker can.
// Every episode above the conventional non-tripping current is recorded with
// what it reached and whether it ended in a trip, which over time bounds the
// real curve: "34 A for 4 minutes and it held" rules out the fast branch, and a
// single genuine trip pins the curve down.
#define MAX_ICP_EVENTS 12
#define ICP_LOG_MAGIC 0x6C
#define ICP_SENS_MAGIC 0x5A   // marks the ICP sensitivity selector written by this firmware
// An episode is closed after this many consecutive readings back below the
// threshold, so a load that dips for a moment does not split into two.
#define ICP_LOG_GRACE_SAMPLES 20
// An episode is recorded when it reaches config.icpLogMinNivel % of danger OR its
// peak current exceeds config.icpLogMinAmp A (catches brief high-current spikes
// that never built thermal danger). Both are user-configurable from the web UI;
// these are the defaults and the accepted ranges. Trips are always recorded
// (logged from recoverICP, never gated).
#define DEF_ICP_LOG_MIN_NIVEL 1
#define DEF_ICP_LOG_MIN_AMP   30.0f
#define ICP_LOG_CFG_MAGIC     0x4B   // marks the configurable log thresholds
#define ENERGY_DAY_MAGIC      0x3C   // marks the daily-energy tracking state
#define ENERGY_HOUR_MAGIC     0x2D   // marks the hourly-energy tracking state
#define ENERGY_DAILY_FILE     "/energy_d.bin"   // LittleFS: one record per completed day
#define ENERGY_MONTHLY_FILE   "/energy_m.bin"   // LittleFS: one record per month (upsert)
#define ENERGY_HOURLY_FILE    "/energy_h.bin"   // LittleFS: one record per completed hour
static void fsEnergyMonthlyUpsert(uint16_t y, uint8_t m, float kwh);  // fwd (used by /import)
static const int   MIN_ICP_LOG_NIVEL = 0,  MAX_ICP_LOG_NIVEL = 100;
static const float MIN_ICP_LOG_AMP   = 0.0f, MAX_ICP_LOG_AMP  = 100.0f;

struct IcpEvent {
  uint32_t ts;        // epoch when the episode started (0 if no valid clock)
  uint16_t durSec;    // duration above the threshold, seconds (saturating)
  uint16_t iMaxCa;    // peak current in centiamps (0.01 A resolution)
  uint8_t  nivelMax;  // peak danger level reached, 0-100 %
  uint8_t  flags;     // bit0: ended in a probable trip (device lost power)
};
#define ICP_EV_TRIPPED 0x01

enum RuleMetric : uint8_t {
  RM_CURRENT = 0,  // A
  RM_VOLTAGE = 1,  // V
  RM_POWER   = 2,  // W
  RM_PF      = 3,  // factor de potencia (0..1)
  RM_FREQ    = 4,  // Hz
  RM_ICP     = 5,  // % carga ICP
  RM_ENERGY  = 6,  // kWh
  RM_COUNT   = 7
};
enum RuleOp : uint8_t { RO_GT = 0, RO_GE = 1, RO_LT = 2, RO_LE = 3, RO_EQ = 4, RO_COUNT = 5 };
enum RuleCombine : uint8_t { RC_AND = 0, RC_OR = 1 };
enum RuleAction  : uint8_t { RA_MQTT = 0, RA_WEBHOOK = 1 };
// Three-valued predicate result: a metric that is NaN this cycle is UNKNOWN, not
// false, so an OR rule still fires on an already-true operand and no edge fires
// on undetermined state.
enum RuleEval : uint8_t { RE_FALSE = 0, RE_TRUE = 1, RE_UNKNOWN = 2 };

#define RULE_FLAG_RETAIN 0x01  // MQTT publish retained
#define RULE_FLAG_POST   0x02  // webhook uses POST (else GET)

static const uint8_t RULE_MIN_SAMPLES = 1, RULE_MAX_SAMPLES = 20, RULE_DEF_SAMPLES = 3;
// Cap on how many evaluate cycles an in-progress edge may stay only PARTIALLY
// delivered (typically an MQTT action whose broker is down): after this many the
// stale pending bits are abandoned so the rule resumes edge detection instead of
// freezing latched. One cycle ~= one refreshInterval; transient webhook-budget or
// WiFi blips recover well within this, so normal delivery semantics are untouched.
static const uint8_t RULE_PENDING_MAX_CYCLES = 30;
static const float   RULE_EQ_EPSILON = 0.05f;   // absolute floor for the '==' operator
static const float   RULE_EQ_REL     = 0.005f;  // + 0.5% relative, so '==' scales with the metric
static const int     WEBHOOK_TIMEOUT_MS = 3000; // per webhook request (blocks only on a rule edge)
// Sentinel returned by fireWebhook when it did NOT attempt a network request
// (WiFi down / low heap): a transient skip that must be retried without
// consuming the per-cycle webhook budget (distinct from an attempted request
// that returned an HTTP status or a small-negative HTTPClient error).
static const int     WEBHOOK_DEFER = -1000;
// Robustness caps for the (blocking) webhook path so a rule edge cannot freeze
// the cooperative loop or exhaust the heap:
#define WEBHOOK_MAX_PER_CYCLE 1                          // at most 1 webhook fired per evaluateRules() pass; rest deferred
static const int      WEBHOOK_TLS_RX = 4096;             // TLS rx buffer: must fit the server's certificate record (1024 was too small)
static const int      WEBHOOK_TLS_TX = 512;
static const uint32_t WEBHOOK_HTTPS_MIN_HEAP = 20000;    // skip HTTPS if free heap below this (BearSSL needs ~16KB)
static const size_t   SAVE_RULES_MAX_BODY = 8000;        // reject oversized /save_rules bodies (bounds parse work)

// ================== MQTT TOPICS =================
#define MQTT_TOPIC_STATE "electricidad/casa/estado"
#define MQTT_TOPIC_ICP_RECOVERY "electricidad/casa/icp"
// One message per overload episode, retained so a late subscriber still sees
// the last one. The EEPROM ring is kept as the offline copy: retained holds a
// single message per topic, so without something archiving these the history
// would live nowhere.
#define MQTT_TOPIC_ICP_EVENT "electricidad/casa/icp_evento"
#define MQTT_TOPIC_ALERTS_CONFIG "electricidad/casa/alertas_config"
#define MQTT_TOPIC_LOG "multimetreitor/serial"
#define MQTT_TOPIC_STATUS "multimetreitor/status"

// ================== DATA STRUCTS ===============
struct MonthlyData {
  uint8_t month;
  uint16_t year;
  float energy_kWh;
};

// One condition of a rule: metric <op> value (e.g. corriente >= 28).
struct RuleCond {
  uint8_t metric;   // RuleMetric
  uint8_t op;       // RuleOp
  float   value;
};

// LEGACY action/rule shapes: the exact layout of the rules that used to live in
// the EEPROM config. Kept ONLY so loadConfig can read the previously stored rules
// once and migrate them into the LittleFS file. Do not change — it must stay
// byte-for-byte identical to the old on-EEPROM layout.
struct RuleActionDefLegacy {
  uint8_t type;
  uint8_t flags;
  char target[96];
  char fire[64];
  char clear[64];
};
struct RuleLegacy {
  uint8_t enabled, combine, samples, condCount, actCount;
  RuleCond conds[MAX_CONDS_LEGACY];
  char name[16];
  RuleActionDefLegacy acts[MAX_ACTIONS_LEGACY];
};

// One action of a rule (MQTT publish or webhook call). Text buffers are trimmed
// from the legacy 96/64/64 so 16 rich rules fit in RAM; still ample for MQTT
// topics and typical URLs/payloads.
struct RuleActionDef {
  uint8_t type;                // RuleAction (RA_MQTT / RA_WEBHOOK)
  uint8_t flags;              // RULE_FLAG_* (retain for MQTT, POST for webhook)
  char target[64];            // MQTT topic OR webhook URL
  char fire[32];              // MQTT message / webhook body sent when the rule activates
  char clear[32];             // sent when it clears (empty = do nothing on clear)
};

// A configurable event trigger. The active table (g_rules[MAX_RULES]) lives in RAM
// and is persisted to a LittleFS file, NOT in the EEPROM config.
struct Rule {
  uint8_t enabled;
  uint8_t combine;              // RuleCombine (how the conditions are joined)
  uint8_t samples;             // consecutive readings before firing (persistence)
  uint8_t condCount;           // 0..MAX_CONDS
  uint8_t actCount;            // 0..MAX_ACTIONS
  RuleCond conds[MAX_CONDS];
  char name[32];               // short label for the UI / logs
  RuleActionDef acts[MAX_ACTIONS];
};

// ---- LEGACY on-EEPROM layout (config schema v11), kept ONLY to read a deployed
// unit's stored config once and migrate it into the clean v12 struct below. This
// is a byte-for-byte copy of the pre-cleanup AppConfig: DO NOT edit it, or a
// deployed unit's config would be misread on upgrade. The static_asserts pin its
// offsets so the compiler proves the migration reads the right bytes.
struct AppConfigV11 {
  uint8_t magic;
  uint8_t version;
  char mqttBroker[32];
  char mqttClient[32];
  unsigned long refreshInterval;
  bool alertaSonora;
  uint8_t lcdMask;
  bool icpEnabled;
  float icpNominal;
  int icpUmbral;
  int icpCurveTimesUnused[6];
  int icpCooldownTime;
  bool consumoEnabled;
  bool consumoEnAmperios;
  float consumoValor;
  bool sobretensionEnabled;
  float sobretensionValor;
  bool subtensionEnabled;
  float subtensionValor;
  time_t lastEnergyReset;
  MonthlyData monthlyHistory[24];
  uint8_t historyIndex;
  uint8_t currentMonth;
  uint16_t currentYear;
  uint8_t lcdLang;
  RuleLegacy rules[MAX_RULES_LEGACY];
  uint8_t rulesMagic;
  float icpK;
  int icpTau;
  int icpAvisoMax;
  uint8_t icpModelMagic;
  IcpEvent icpLog[MAX_ICP_EVENTS];
  uint8_t icpLogIndex;
  uint8_t icpLogCount;
  uint8_t icpLogMagic;
  uint8_t icpSensibilidad;
  uint8_t icpSensMagic;
  float   icpLogMinAmp;
  uint8_t icpLogMinNivel;
  uint8_t icpLogCfgMagic;
  float   dayStartEnergy;
  uint8_t currentDay;
  uint8_t energyDayMagic;
  float   hourStartEnergy;
  uint8_t currentHour;
  uint8_t energyHourMagic;
};

// Layout guards for the LEGACY struct: these are the ground-truth offsets the
// deployed v11 firmware actually wrote (xtensa target compiler; time_t is 8 bytes).
// They must hold so the one-time v11->v12 migration reads the right bytes; a drift
// here fails the BUILD instead of silently misreading a deployed unit's config.
static_assert(offsetof(AppConfigV11, lcdLang) == 340, "v11 layout drifted before rules; migration would misread");
static_assert(offsetof(AppConfigV11, rules) == 344, "v11 rules[] offset moved; migration is unsafe");
static_assert(offsetof(AppConfigV11, rulesMagic) == 3344, "v11 rules[] block size drifted; migration would misread");
static_assert(offsetof(AppConfigV11, icpSensMagic) == 3512, "v11 tail drifted; migration would misread");
// Pin the WHOLE tail (the sensitivity/log-cfg/day/hour blocks migrateV11toV12 reads
// under their magic guards): the last field's offset + the total size lock every
// byte after icpSensMagic, so any accidental edit to the v11 tail fails the BUILD.
static_assert(offsetof(AppConfigV11, energyHourMagic) == 3537, "v11 tail drifted past the sensitivity block; migration would misread");
static_assert(sizeof(AppConfigV11) == 3544, "v11 struct size drifted; migration and EEPROM_SIZE would be wrong");

// ---- ACTIVE config (schema v12): the clean struct. Everything that grows now
// lives in LittleFS (forensic log, rules, monthly/daily/hourly history), so the
// EEPROM only holds these small fixed settings + ICP calibration + period anchors.
// A single magic+version guards the WHOLE struct: any future layout change just
// bumps CONFIG_VERSION (no more per-block magic guards, no more append-without-bump).
struct AppConfig {
  uint8_t  magic;
  uint8_t  version;

  // Connectivity + UI
  char     mqttBroker[32];
  char     mqttClient[32];
  unsigned long refreshInterval;
  bool     alertaSonora;
  uint8_t  lcdMask;
  uint8_t  lcdLang;

  // ICP protection + thermal-image model + forensic-log thresholds
  bool     icpEnabled;
  float    icpNominal;
  int      icpUmbral;
  int      icpCooldownTime;   // tau2: cooling time constant with no load (s)
  float    icpK;              // asymptote: I/In below which the breaker never trips
  int      icpTau;            // tau1: thermal time constant under load (s)
  int      icpAvisoMax;       // countdown span of the bar (s)
  uint8_t  icpSensibilidad;   // 0-100 % sensitivity selector
  float    icpLogMinAmp;      // OR peak current (A) that records an episode
  uint8_t  icpLogMinNivel;    // danger level (%) that records an episode

  // Consumption / voltage alerts
  bool     consumoEnabled;
  bool     consumoEnAmperios;
  float    consumoValor;
  bool     sobretensionEnabled;
  float    sobretensionValor;
  bool     subtensionEnabled;
  float    subtensionValor;

  // Energy period anchors (the per-period totals themselves live in LittleFS)
  time_t   lastEnergyReset;
  uint8_t  currentMonth;
  uint16_t currentYear;
  float    dayStartEnergy;    // cumulative kWh at the start of the current day
  uint8_t  currentDay;        // day-of-month of the current day (0 = uninitialised)
  float    hourStartEnergy;   // cumulative kWh at the start of the current hour
  uint8_t  currentHour;       // hour-of-day 0-23 (0xFF = uninitialised)
};

static_assert(sizeof(AppConfig) <= 4096, "AppConfig exceeds one EEPROM sector (4096 B)");
static_assert(sizeof(AppConfig) <= sizeof(AppConfigV11), "v12 config must be no larger than the v11 buffer it migrates from");

// ================== LCD TEXT & ALERTS ==========
struct LCDLines {
  char l1[17];
  char l2[17];
};

struct AlertState {
  bool any;
  char msg[17];
  char value[17];
  // Individual active-alert flags, exposed as the "alerts" array in /json and MQTT
  bool icp;
  bool sobre;
  bool sub;
  bool consumo;
};

// ================== GLOBAL STATE ===============
AppConfig config;

float voltage = NAN, current = NAN, power = NAN, energy = NAN, powerFactor = NAN, frequency = NAN;

// Last evaluated alert state, so /json and MQTT can report active alerts
AlertState lastAlert = { false, "", "", false, false, false, false };

// Rule engine runtime state (kept out of the persisted config): the latched
// on/off state of each rule and its persistence counter (counts toward whichever
// edge is pending).
//
// KNOWN LIMITATIONS (documented on purpose, not bugs):
//  1) The latch is RAM-only. After a reboot/OTA a rule re-evaluates from scratch,
//     so a still-true condition re-fires its activate action once (idempotent for
//     retained MQTT; a non-idempotent webhook would run again). Persisting the
//     latch was rejected to avoid EEPROM wear.
//  2) Rules share the single EEPROM blob (AppConfig) with the 24-month energy
//     history, so a power loss during a /save_rules commit could, worst case,
//     corrupt the blob and reset it to defaults (losing history). Splitting the
//     history into its own CRC-guarded sector is future work.
bool ruleLatch[MAX_RULES] = { false };
uint8_t ruleSampleCount[MAX_RULES] = { 0 };
// Multi-action delivery state: bitmask of actions still to deliver for the
// in-progress edge, and whether those pending actions are the CLEAR payloads.
// The latch flips at edge-commit; these drive per-action delivery/retry after.
uint8_t ruleActPending[MAX_RULES] = { 0 };
bool ruleActClearEdge[MAX_RULES] = { false };
// Cycles the current edge has stayed only partially delivered; bounds the
// broker-down freeze (see RULE_PENDING_MAX_CYCLES).
uint8_t rulePendingAge[MAX_RULES] = { 0 };

// The active rule table. Lives in RAM (persisted to RULES_FILE on LittleFS), NOT
// in the EEPROM config. g_ruleCount is how many of the MAX_RULES slots are in use.
Rule g_rules[MAX_RULES];
uint8_t g_ruleCount = 0;

float icpCarga = 0.0f;
unsigned long lastIcpMillis = 0;
bool icpPrimed = false;
float icpEpisodioIMax = 0.0f;   // peak current of the overload episode in progress

// The danger bar the user sees, 0-100 % of the warning window counted down to
// the trip. Held here rather than derived on demand because it carries one bit
// of history: it may rise instantly but may only fall at the cooling rate (see
// computeICP). Deliberately NOT persisted — on boot the thermal state is a
// guess anyway (see the seeding block in computeICP) and one cycle of the model
// rebuilds it. NAN until the first reading. See icpNivelPeligro().
float icpBarra = NAN;

time_t ntpEpoch = 0;
unsigned long ntpSyncMillis = 0;
bool ntpOK = false;
bool ntpAlgunaVezValida = false;
unsigned long lastNTPSync = 0;
unsigned long ntpWaitStart = 0;
bool ntpTimeout = false;

unsigned long lastWiFiAttempt = 0, lastMQTTAttempt = 0;
int wifiTries = 0, mqttTries = 0;
bool wifiOk = false, mqttOk = false;

bool icpRecuperado = false;
bool publicarListo = false;
float icpRecibidoMQTT = NAN;
float iRecibidoMQTT = 0.0f;   // current reported by the retained payload
time_t tsRecibidoMQTT = 0;
bool icpRecibido = false, tsRecibido = false;

// Replaced String with char arrays for memory optimization
char lcdLine1[17] = "                ";
char lcdLine2[17] = "                ";

unsigned long lastUpdate = 0;

// Protected EEPROM global state
unsigned long lastBackgroundEEPROMSave = 0;
const unsigned long EEPROM_COOLDOWN_MS = 3600000UL; // 1 hour

// ================== HW OBJECTS =================
SoftwareSerial pzemSerial(D6, D5);  // RX, TX
PZEM004Tv30 pzem(pzemSerial);
ESP8266WebServer server(80);
LiquidCrystal_I2C lcd(0x27, 16, 2);
WiFiClient espClient;
PubSubClient mqttClient(espClient);

// ================== EEPROM SIZE ===============
// Sized to the LEGACY (v11) struct, not the smaller v12 one: loadConfig() overlays
// a v11 layout on this RAM buffer to detect+migrate a deployed unit, so the buffer
// must be big enough to hold the whole v11 struct. The live v12 config is far
// smaller; the extra buffer bytes are just unused tail (cleared on /wipe).
#define EEPROM_SIZE sizeof(AppConfigV11)

// ================== UTILS =====================
time_t getCurrentEpoch();  // fwd
static void formatElapsedTimeTo(char* buf, size_t n, time_t timestamp);  // fwd

template<size_t N>
inline void safeCopy(char (&dst)[N], const String& src) {
  src.toCharArray(dst, N);
  dst[N - 1] = '\0';
}

// Single source of truth for elapsed-time text (Spanish), shared with /json.
String formatElapsedTime(time_t timestamp) {
  char buf[32];
  formatElapsedTimeTo(buf, sizeof(buf), timestamp);
  return String(buf);
}

void logMessage(const String& msg) {
  Serial.println(msg);
  if (mqttOk && mqttClient.connected()) mqttClient.publish(MQTT_TOPIC_LOG, msg.c_str(), false);
}

// ================== CONFIG =====================
void setDefaults() {
  config.magic = CONFIG_MAGIC;
  config.version = CONFIG_VERSION;
  safeCopy(config.mqttBroker, DEF_MQTT_BROKER);
  safeCopy(config.mqttClient, DEF_MQTT_CLIENT);
  config.refreshInterval = DEF_REFRESH_MS;
  config.alertaSonora = DEF_ALERTA_SONORA;
  config.lcdMask = DEF_LCD_MASK;
  config.lcdLang = DEF_LCD_LANG;

  config.icpEnabled = DEF_ICP_ENABLED;
  config.icpNominal = DEF_ICP_NOMINAL;
  config.icpUmbral = DEF_ICP_UMBRAL;
  config.icpCooldownTime = DEF_ICP_COOLDOWN;
  config.icpK = DEF_ICP_K;
  config.icpTau = DEF_ICP_TAU;
  config.icpAvisoMax = DEF_ICP_AVISO_MAX;
  config.icpSensibilidad = DEF_ICP_SENS;
  config.icpLogMinAmp = DEF_ICP_LOG_MIN_AMP;
  config.icpLogMinNivel = DEF_ICP_LOG_MIN_NIVEL;

  config.consumoEnabled = DEF_CONSUMO_ENABLED;
  config.consumoEnAmperios = DEF_CONSUMO_TIPO_A;
  config.consumoValor = DEF_CONSUMO_VAL;
  config.sobretensionEnabled = DEF_SOBRET_ENABLED;
  config.sobretensionValor = DEF_SOBRET_VAL;
  config.subtensionEnabled = DEF_SUBT_ENABLED;
  config.subtensionValor = DEF_SUBT_VAL;

  config.lastEnergyReset = 0;
  config.currentMonth = 0;
  config.currentYear = 0;
  config.dayStartEnergy = 0.0f;
  config.currentDay = 0;
  config.hourStartEnergy = 0.0f;
  config.currentHour = 0xFF;
}

void saveConfig() {
  EEPROM.put(0, config);
  EEPROM.commit();
}

// Protected save for automated background tasks
void safeBackgroundSaveConfig() {
  unsigned long now = millis();
  if (lastBackgroundEEPROMSave == 0 || (now - lastBackgroundEEPROMSave >= EEPROM_COOLDOWN_MS)) {
    saveConfig();
    lastBackgroundEEPROMSave = now;
    logMessage(F("[EEPROM] Background save executed."));
  } else {
    logMessage(F("[EEPROM] Background save skipped (cooldown active)."));
  }
}

// True when every HARD-validated field is in range. A failure here means the
// config is wiped to defaults (the same fields v11 wiped over): connectivity,
// refresh, ICP nominal/umbral/cooldown, and any enabled voltage limit.
static bool configHardFieldsValid() {
  if (config.refreshInterval < MIN_REFRESH_MS || config.refreshInterval > MAX_REFRESH_MS) return false;
  size_t bl = strnlen(config.mqttBroker, sizeof(config.mqttBroker));
  size_t cl = strnlen(config.mqttClient, sizeof(config.mqttClient));
  if (bl < 7 || bl > 31) return false;
  if (cl < 3 || cl > 31) return false;
  if (isnan(config.icpNominal) || config.icpNominal < MIN_ICP_NOMINAL_A || config.icpNominal > MAX_ICP_NOMINAL_A) return false;
  if (config.icpUmbral < MIN_ICP_UMBRAL || config.icpUmbral > MAX_ICP_UMBRAL) return false;
  if (config.icpCooldownTime < MIN_ICP_COOLDOWN_S || config.icpCooldownTime > MAX_ICP_COOLDOWN_S) return false;
  if (config.sobretensionEnabled && (config.sobretensionValor < MIN_VOLTAGE_LIMIT || config.sobretensionValor > MAX_VOLTAGE_LIMIT)) return false;
  if (config.subtensionEnabled && (config.subtensionValor < MIN_VOLTAGE_LIMIT || config.subtensionValor > MAX_VOLTAGE_LIMIT)) return false;
  return true;
}

// Clamps the SOFT fields in place (a bad value is defaulted, not wiped) — exactly
// what the v11 per-block magic-guard else-branches did, now that a single version
// guard covers the whole struct. Idempotent, so it is safe to run every boot.
static void configClampSoftFields() {
  if (config.lcdLang > LANG_EN) config.lcdLang = DEF_LCD_LANG;
  if (isnan(config.icpK) || config.icpK < MIN_ICP_K || config.icpK > MAX_ICP_K) config.icpK = DEF_ICP_K;
  if (config.icpTau < MIN_ICP_TAU_S || config.icpTau > MAX_ICP_TAU_S) config.icpTau = DEF_ICP_TAU;
  if (config.icpAvisoMax < MIN_ICP_AVISO_S || config.icpAvisoMax > MAX_ICP_AVISO_S) config.icpAvisoMax = DEF_ICP_AVISO_MAX;
  if (config.icpSensibilidad > MAX_ICP_SENS) config.icpSensibilidad = DEF_ICP_SENS;
  if (isnan(config.icpLogMinAmp) || config.icpLogMinAmp < MIN_ICP_LOG_AMP || config.icpLogMinAmp > MAX_ICP_LOG_AMP) config.icpLogMinAmp = DEF_ICP_LOG_MIN_AMP;
  if (config.icpLogMinNivel > MAX_ICP_LOG_NIVEL) config.icpLogMinNivel = DEF_ICP_LOG_MIN_NIVEL;
  if (isnan(config.dayStartEnergy) || config.dayStartEnergy < 0.0f) config.dayStartEnergy = 0.0f;
  if (config.currentDay > 31) config.currentDay = 0;
  if (isnan(config.hourStartEnergy) || config.hourStartEnergy < 0.0f) config.hourStartEnergy = 0.0f;
  if (config.currentHour > 23 && config.currentHour != 0xFF) config.currentHour = 0xFF;
}

// One-time upgrade of a deployed v11 EEPROM into the clean v12 struct. Reads only
// the fields the cleanup keeps, honouring each v11 magic guard exactly as the v11
// loadConfig() trusted it, then persists v12. The bulk data (forensic log, rules,
// monthly/daily/hourly history) already lives in LittleFS, untouched by this.
static void migrateV11toV12(const AppConfigV11 &old) {
  setDefaults();   // v12 defaults + magic + version; every kept field starts sane

  // Guardless v11 fields (v11 already range-checked the hard ones on its own boot).
  strlcpy(config.mqttBroker, old.mqttBroker, sizeof(config.mqttBroker));
  strlcpy(config.mqttClient, old.mqttClient, sizeof(config.mqttClient));
  config.refreshInterval     = old.refreshInterval;
  config.alertaSonora        = old.alertaSonora;
  config.lcdMask             = old.lcdMask;
  config.lcdLang             = (old.lcdLang > LANG_EN) ? DEF_LCD_LANG : old.lcdLang;
  config.icpEnabled          = old.icpEnabled;
  config.icpNominal          = old.icpNominal;
  config.icpUmbral           = old.icpUmbral;
  config.consumoEnabled      = old.consumoEnabled;
  config.consumoEnAmperios   = old.consumoEnAmperios;
  config.consumoValor        = old.consumoValor;
  config.sobretensionEnabled = old.sobretensionEnabled;
  config.sobretensionValor   = old.sobretensionValor;
  config.subtensionEnabled   = old.subtensionEnabled;
  config.subtensionValor     = old.subtensionValor;
  config.lastEnergyReset     = old.lastEnergyReset;
  config.currentMonth        = old.currentMonth;
  config.currentYear         = old.currentYear;

  // Magic-guarded v11 blocks: carry over only when the marker validates (exactly
  // what v11 trusted); otherwise keep the safe default setDefaults() already wrote.
  // icpCooldownTime is tied to the thermal model, so it travels with that guard:
  // a pre-model config stored a differently-meaning cooldown that v11 also reset.
  if (old.icpModelMagic == ICP_MODEL_MAGIC) {
    config.icpK            = old.icpK;
    config.icpTau          = old.icpTau;
    config.icpAvisoMax     = old.icpAvisoMax;
    config.icpCooldownTime = old.icpCooldownTime;
  }
  if (old.icpSensMagic == ICP_SENS_MAGIC) {
    config.icpSensibilidad = old.icpSensibilidad;
  } else {
    // v11 recalibrated the thermal model to the sensitivity-era defaults whenever
    // the sensitivity block was absent (the old k/tau/cooldown were a different
    // calibration). Replicate that exactly, so a pre-sensitivity v11 unit upgrades
    // to the same params v11 would have adopted. (avisoMax was NOT reset by v11.)
    config.icpSensibilidad = DEF_ICP_SENS;
    config.icpK            = DEF_ICP_K;
    config.icpTau          = DEF_ICP_TAU;
    config.icpCooldownTime = DEF_ICP_COOLDOWN;
  }
  if (old.icpLogCfgMagic == ICP_LOG_CFG_MAGIC) {
    config.icpLogMinAmp   = old.icpLogMinAmp;
    config.icpLogMinNivel = old.icpLogMinNivel;
  }
  if (old.energyDayMagic == ENERGY_DAY_MAGIC) {
    config.dayStartEnergy = old.dayStartEnergy;
    config.currentDay     = old.currentDay;
  }
  if (old.energyHourMagic == ENERGY_HOUR_MAGIC) {
    config.hourStartEnergy = old.hourStartEnergy;
    config.currentHour     = old.currentHour;
  }

  // Same clamps/validation a normal v12 load applies, so a tampered or half-written
  // v11 EEPROM cannot carry an out-of-range value across the upgrade.
  configClampSoftFields();
  if (!configHardFieldsValid()) setDefaults();

  config.magic   = CONFIG_MAGIC;
  config.version = CONFIG_VERSION;
  saveConfig();   // persist the clean v12; the leftover v11 tail bytes are now inert
  logMessage(F("[CONFIG] Migrated EEPROM v11 -> v12 (struct cleanup)."));
}

void loadConfig() {
  // Detect a deployed v11 config by its schema bytes: magic and version sit at
  // offset 0/1 in BOTH layouts, so a two-byte peek decides without reading the
  // whole struct. (This migration assumes the bulk data already lives in LittleFS,
  // which every unit that ran the intervening firmware phases has — the EEPROM no
  // longer carries the rules/log/monthly arrays to seed from.)
  if (EEPROM.read(0) == CONFIG_MAGIC && EEPROM.read(1) == CONFIG_VERSION_V11) {
    // Copy the ~3.5 KB v11 image into a HEAP temporary (never the 4 KB boot stack)
    // via EEPROM.get — a plain memcpy, so no strict-aliasing/lifetime concern —
    // then migrate it into the clean v12 struct and release it.
    AppConfigV11 *old = (AppConfigV11 *)malloc(sizeof(AppConfigV11));
    if (old) {
      EEPROM.get(0, *old);
      migrateV11toV12(*old);
      free(old);
      return;   // config is now a persisted, valid v12
    }
    // malloc failing this early (heap is barely used at boot) is essentially
    // impossible; if it ever did, fall through to the v12 path, which resets to
    // defaults (recoverable via /import) rather than reading an uninitialised config.
  }

  // Normal path: the config is already v12 (or the EEPROM is fresh / corrupt).
  EEPROM.get(0, config);
  bool defaults = (config.magic != CONFIG_MAGIC) || (config.version != CONFIG_VERSION);
  if (!defaults && !configHardFieldsValid()) defaults = true;
  if (defaults) {
    setDefaults();
    saveConfig();
    return;   // fresh defaults are already clean
  }
  configClampSoftFields();
}

// ================== WIFI =======================
void readSensorsAndTriggerAlerts();  // fwd: the boot waits keep watching the mains

// Blocks at most timeoutMs waiting for a connection; returns whether it connected.
// Keeps measuring throughout: this is up to 2x20 s of the boot, and a breaker
// does not wait for DHCP.
static bool waitWiFiConnected(unsigned long timeoutMs) {
  unsigned long start = millis();
  while (WiFi.status() != WL_CONNECTED) {
    if (millis() - start > timeoutMs) return false;
    readSensorsAndTriggerAlerts();
    delay(50);
    yield();
  }
  return true;
}

void setupWiFi() {
  // Disable Nagle on all TCP connections (MQTT publishes and web responses):
  // small packets go out immediately instead of waiting up to ~40ms for an ACK.
  WiFiClient::setDefaultNoDelay(true);
  WiFi.mode(WIFI_STA);
  WiFi.hostname(WIFI_HOSTNAME);
  wifiTries = 0;
  wifiOk = false;

  // 1) Try with the configured static IP first.
  WiFi.config(local_ip, gateway, subnet, dns);
  WiFi.begin(ssid, password);
  lastWiFiAttempt = millis();
  if (waitWiFiConnected(WIFI_SETUP_TIMEOUT_MS)) {
    wifiOk = true;
    Serial.println(F("[WiFi] Connected (static IP)."));
    return;
  }

  // 2) Fall back to DHCP (e.g. moved to a different network/subnet).
  Serial.println(F("[WiFi] Static IP failed; trying DHCP..."));
  WiFi.disconnect();
  WiFi.config(IPAddress(0, 0, 0, 0), IPAddress(0, 0, 0, 0), IPAddress(0, 0, 0, 0));
  WiFi.begin(ssid, password);
  lastWiFiAttempt = millis();
  if (waitWiFiConnected(WIFI_SETUP_TIMEOUT_MS)) {
    wifiOk = true;
    Serial.println(F("[WiFi] Connected (DHCP)."));
    return;
  }

  // 3) Do not block the boot any longer: keepWifiAlive() keeps retrying in
  //    loop(), so the web server / OTA still come up once WiFi is back.
  wifiOk = false;
  Serial.println(F("[WiFi] Not connected; continuing boot, will keep retrying in loop()."));
}

void keepWifiAlive() {
  if (WiFi.status() == WL_CONNECTED) {
    wifiOk = true;
  } else {
    wifiOk = false;
    unsigned long now = millis();
    if (wifiTries < 3 && now - lastWiFiAttempt > WIFI_RETRY_INTERVAL_MS) {
      wifiTries++;
      WiFi.disconnect();
      WiFi.begin(ssid, password);
      lastWiFiAttempt = now;
      Serial.printf_P(PSTR("[WiFi] Attempt %d to connect to %s\n"), wifiTries, ssid);
    }
    if (wifiTries >= 3 && now - lastWiFiAttempt > WIFI_COOLDOWN_INTERVAL_MS) {
      wifiTries = 0;
      lastWiFiAttempt = now;
      Serial.println(F("[WiFi] Cooldown elapsed, retrying..."));
    }
  }
}
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
void loop() {
  keepWifiAlive();
  handleOTA();
  keepSyncNTP();
  keepMQTTAlive();
  server.handleClient();
  readSensorsAndTriggerAlerts();
  updateMonthlyEnergyHistory();
}
