tonikelope/multimetreitor/(commit log)

2026-05-30 Fix bugs: non-blocking WiFi setup + DHCP fallback, MQTT buffer 512B, POST upper-bound validation, unify elapsed-time language, NaN-safe history save, OTA progress div-by-zero
    [multimetreitor.ino]
2026-05-30 ICP: self-contained retained recovery publish + clamp dt against loop stalls
    [multimetreitor.ino]
2026-05-30 Web UI: ES/EN i18n with language toggle button (default Spanish, persisted in localStorage)
2026-05-30 README: document bilingual ES/EN UI (web + Rainmeter) and how to switch
2026-05-30 Web UI fix: define applyLang as assignment (window.applyLang=function) so Arduino's auto-prototype generator doesn't inject a C++ prototype into the JS and break the whole script
    [multimetreitor.ino]
2026-05-30 Fix monthly rollover durability: force-save EEPROM on month change (was throttled and lost on reboot); add /fix_period maintenance endpoint to correct period label without touching energy/history
    [multimetreitor.ino]
2026-06-06 Add anti-flapping to voltage and current/power alerts: trigger persistence (3 consecutive readings beyond the limit, so brushing the threshold for an instant does not fire) plus hysteresis on clear (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
2026-06-06 Performance package (measured on-device, before -> after): per-character LCD diff rendering without clear() (54ms -> 7-9ms typical per cycle, no flicker), config page streamed from PROGMEM in 2.9KB t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
    [multimetreitor.ino]
2026-06-24 Bilingual LCD/web messages with a persisted language setting (default Spanish)
    On-screen text messages (boot splash + the four alert warnings: ICP trip,
    overvoltage, undervoltage, consumption) are now bilingual ES/EN. The active
    language lives in a single device-side setting, config.lcdLang, persisted in
    EEPROM and defaulting to Spanish. Numeric readings and status symbols stay
    as-is (universal).
    The existing web UI language toggle now, besides translating the interface
    client-side as before, also sends GET /set_lang?lang=es|en so the device
    persists the choice and the LCD follows it. The config page is rendered
    server-side with a %LANG% token, so a fresh browser loads the language stored
    o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
2026-07-15 Add a configurable rule engine (event triggers) with a tabbed web editor
    Native replacement for the external calentador.py hysteresis controller.
    Each rule evaluates 1-3 conditions (metric >, >=, <, <=, == value) joined by
    AND/OR with anti-bounce persistence, and fires up to 2 actions on the edge:
    publish an MQTT topic or call a webhook (HTTP/HTTPS), each with an activate
    payload and an optional clear payload.
    Engine: symmetric N-sample debounce on both edges; three-valued condition
    evaluation (a NaN metric is UNKNOWN, so an OR still fires on a true operand
    and no edge fires on a bad PZEM sample); deliver-or-retry semantics (MQTT
    retries until published, a webhook fires once and reports the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
    [multimetreitor.ino]
2026-07-20 Replace the ICP overload-time integrator with a thermal-image model
    The old model accumulated dt/t_trip over a 6-point curve: a counter of
    overload time, not a temperature. It therefore assumed a cold breaker at
    the start of every overload, cooled linearly, treated the 1.00-1.13xIn
    band as full-speed cooling, and tripped instantly above 2.15xIn.
    Located the official Merlin Gerin ICP-M curve (Multi 9 catalogue 2003/2004,
    covering the C32N ICP-M actually installed here) and digitised it. It puts
    the magnetic release at 5-8xIn (135-220 A on this 25 A unit), so the instant
    trip at 53.75 A had no basis; between 2.15x and 5.4x only the bimetal acts
    and the catalogue allows 1.4-116 s. The envelope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
    [multimetreitor.ino]
2026-07-20 Make the ICP bar a countdown, so its percentage means time to react
    Showing the thermal level made the same percentage mean wildly different
    margins: 50 % of heat is ten seconds away from tripping at 64 A and six
    minutes away at 33 A. The number that matters when the bar moves is how
    long there is to go and switch something off, so the bar now shows how much
    of a configurable warning window has already been used up.
    New setting icpAvisoMax (default 120 s, range 15-1800). Empty bar means at
    least that much time remains, or that the present load cannot trip the
    breaker at all; full means it trips now. At constant current the time left
    falls one second per second, so the bar fills at a steady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
2026-07-20 Record every ICP overload episode, to calibrate against the real breaker
    The manufacturer's envelope spans a factor ~80 in trip time, so no catalogue
    can say where this particular unit sits inside it, and after ~39 years there
    is no published data on drift either. The breaker itself is the only source
    left, so every episode above the conventional non-tripping current is now
    logged: start time, duration above the threshold, peak current, peak danger
    level, and whether it ended in a trip.
    Each episode that does NOT trip is a bound on the real curve ("34 A for four
    minutes and it held" rules out the fast branch); one that does trip pins it
    down almost completely.
    A trip is detectable because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
    [multimetreitor.ino]
2026-07-20 Carry the current in the retained ICP payload, so a trip is attributable
    A recorded trip was missing the one number needed to calibrate the curve: the
    current at which it happened. The device sits behind the breaker, so a trip
    takes it down before it can write anything, and the retained payload only
    carried the thermal level and a timestamp. The recovered event therefore said
    "it tripped at 78 % of the model" without saying at how many amps, which is
    useless for deciding whether the model runs fast or slow.
    The payload now also carries 'i' (current at the last publish) and 'imax'
    (peak of the overload episode in progress), and recoverICP feeds them into the
    forensic entry. Both keys are opt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
    [multimetreitor.ino]
2026-07-20 Publish each ICP episode to MQTT as well as the local ring
    The EEPROM ring holds twelve events and has to be read from the device. Publishing each episode (retained, with the model parameters in force at the time) lets anything subscribed archive them without limit. The ring stays as the offline copy: retained keeps a single message per topic, so with nothing archiving them the history would otherwise live nowhere, and the broker may be down exactly when an episode ends.
    [multimetreitor.ino]
2026-07-20 Configure the ICP curve with one number in amps instead of k and tau
    Fitting the manufacturer's curve leaves k and tau tied together as tau = 449/k^2.3, within 0.5 % across the whole catalogue band and far inside the ~10 % error of reading the printed graph. Asking for both was asking for redundant information in units nobody thinks in.
    The form now asks for the current above which this breaker eventually trips (k*In, 32.5 A by default) and derives k, tau and the cooldown from it, with the trip-time table updating as it is typed. The raw values move under a collapsed advanced section and stay editable, since the forensic log may eventually show this unit does not follow the catalogue family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
    [multimetreitor.ino]
2026-07-20 Rename the ICP curve setting: it is an asymptote, not a trip point
    'Salta a partir de 32,5 A' claimed a sharp cutoff that does not exist: at 32.5 A the breaker never trips at all, and at 32.6 A it takes 21 minutes. The field is the asymptote the bimetal heats towards, so it now reads 'aguanta siempre hasta', and the help text says outright that just above it takes tens of minutes and that the table shows the rest.
2026-07-20 Show the ratio next to the amps in the ICP setting
    The 32.5 A is not an independent number, it is 1.30 x In, and the ratio is what the catalogue is expressed in (band 1.13 to 1.45). Showing only the amps hid that relationship, so the field now reads '32.50 A = 1.30 x In (the catalogue allows 1.13 to 1.45)', which also makes it obvious that changing the nominal current moves the amps and not the ratio.
2026-07-20 Set the ICP curve with the ratio alone, and strip the help text
    The ratio is the only thing worth asking for: everything else follows from
    it. The current in amps is k*In and tau comes from fitting the catalogue
    curve, so both are now shown as a single derived line under the field
    instead of being typed. tau and the cooldown stay editable under a collapsed
    "advanced" section for the day the forensic log says this unit does not
    follow the catalogue family, and they are recomputed whenever the ratio is
    touched.
    Also removed three explanatory paragraphs from the box (the computed-curve
    note, the catalogue-band note under the ratio and the one describing the
    bar), which were noise for anyone wh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
    [multimetreitor.ino]
2026-07-20 Redraw the script-written ICP texts when the language changes
    applyLang only replaces elements carrying data-i18n, and the countdown summary, the derived line under the ratio and the trip-time table are all written by the script, so switching to English left them in Spanish. They are now redrawn from applyLang along with the rest.
    [multimetreitor.ino]
2026-07-24 Replace the ICP k field with a single sensitivity selector across the band
    The advanced curve control was a raw k number; swap it for one "ICP
    sensitivity" slider (0-100 %) that slides the assumed thermal preload
    from the slow branch of the UNE 20317 curve up to the fast (worst-case)
    branch, spanning the whole catalogue band with a single knob. k and tau
    stay fixed and hidden, fitted to the slow branch (k=1.07, tau=384).
    - Default 100 % (worst case) so the warning never fires late by default.
    - The selector applies as a floor on the thermal state in
    icpSegundosRestantes, so the countdown, bar and alarm all read the
    worst-case time-to-trip for the present current; the real integrated
    h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
    [multimetreitor.ino]
2026-07-24 Say the ICP warning fires with that many seconds or less
    The threshold summary read "warns when N s are left before the trip",
    which implies a fixed margin. With the worst-case curve a hard overload
    trips sooner than the threshold time, so the alert fires with N s OR LESS
    of margin. Word it that way to match the actual behaviour.
    [multimetreitor.ino]
2026-07-25 Document the ICP thermal model in the README
    Add a dedicated section covering the ICP: the UNE 20317 reference band,
    the IEC 60255-149 first-order thermal-image algorithm, the worst-case
    sensitivity selector, exponential cooling, and the countdown/warning bar,
    with the trip-band and web-panel screenshots. Also refresh two stale
    one-liners that still described the old logarithmic-interpolation model.
2026-07-25 Document the rules engine in the README
    Add a Rules / Triggers section (conditions, operators, AND/OR, MQTT and
    webhook actions, edge-triggered activate/clear, persistence, limits and
    the water-heater load-shedding example) illustrated with docs/ruleA.png
    and docs/ruleB.png. Also weave the rules engine into the intro, the
    feature list, the firmware-architecture blocks and the Rainmeter note.
2026-07-25 ICP: default tau2 to 576 s (~1.5x tau) and document model caveats
    De-energized cooling has no internal heat source, only convection to
    ambient, so it is slower than energized heating. Defaulting tau2 = tau
    (384 s) under-estimated residual heat after a trip, the one spot where
    the model broke its otherwise worst-case-conservative stance. Bump
    DEF_ICP_COOLDOWN to 576 s (clamped range 60..7200 unchanged; existing
    devices keep their stored value until wiped).
    README:
    - Clarify the model targets a physical thermal-magnetic ICP (ICP-M);
    an electronic-meter cut-off (telegestion / maximetro) behaves
    differently and is not described by this model.
    - Make explicit that at the 100% default an isol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
    [multimetreitor.ino]
2026-07-29 ICP: make the bar read the thermal level instead of a countdown
    The bar was the countdown expressed as a percentage of the warning
    window. Two flaws showed up on the real device: the time estimate has a
    pole at I = k*In, so the bar leapt between empty and half full over a
    couple of amps and vanished entirely on a small dip, and the sensitivity
    floor overrode the integrated heat in icpSegundosRestantes(), leaving the
    reading a pure function of the instantaneous current with no thermal
    memory at all. The forensic log recorded a 76 s episode peaking at 29 A
    with the bar pinned at 0 % throughout, and an 18 h one at 28.3 A likewise.
    The bar is now the thermal level itself, rescaled onto the band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
2026-08-01 ICP: make the bar a countdown to the trip and fix the audit findings
    The bar is now the warning window counted down: bar = 100*(1 - t_left/window),
    so half full means half the window left at any current and the threshold reads
    directly as a margin (40 % of 120 s = 72 s). It may rise instantly but may only
    fall at the bimetal's cooling rate, which is what stops it flashing when the
    load dips for a moment. Replaces the rescaled-temperature bar and removes
    icpBarraH0 and ICP_BAR_H0_MAX entirely.
    An adversarial audit of the previous bar found three defects, all traced to its
    zero point being floored at 1/k^2:
    - icpAvisoMax had no observable effect at all. The floor does not depend on it,
    and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
    [multimetreitor.ino]
2026-08-01 ICP: start watching the mains from the first loop of setup()
    Measuring, modelling and warning never needed the network, but they were gated
    behind publicarListo, which is only set at the very end of recoverICP(). With
    WiFi (2x20 s), NTP (30 s), MQTT (5 s) and the retained-state wait (3 s) ahead of
    it, the worst case left the device blind for ~75 s — and the worst case is
    exactly a power cut, when the router is booting too and the whole house comes
    back on at once. That is the likeliest minute of the year for the breaker to
    trip, and it was the one minute nothing was being watched.
    readSensorsAndTriggerAlerts() now runs the PZEM read, the thermal model, the
    forensic log, the alert latches,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
2026-08-01 README: document that ICP protection does not wait for the network
    The Persistence section described the retained-state recovery as the whole story
    of how the thermal state survives a reboot. Since cfc6931 that is only half of
    it: the recovery needs MQTT and NTP, and the case where it matters most (a
    general power cut, with the router booting too) has neither.
    Spells out that the PZEM read, the model, the forensic log, the alerts, the
    buzzer and the LCD all run from the first loop of setup() and through every
    blocking boot wait (~75 s worst case), that only the rule engine and the MQTT
    publish wait for the network, and that the retained value and the measured state
    are complementary — the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
2026-08-01 Rules: fix the adversarial-audit findings (broker-down freeze, retained wipe, layout guard, save dirty-check)
    An adversarial audit of the rule engine surfaced four issues, all fixed here.
    No AppConfig layout change, so existing rules and the energy history survive the
    OTA (verified below).
    - Broker-down freeze (medium): a rule with an MQTT action whose broker was
    unreachable when an edge committed stopped detecting edges until the broker
    returned, because evaluateRules skipped the predicate while any action stayed
    pending and an MQTT pending bit only clears on a successful publish. Add
    rulePendingAge[] + RULE_PENDING_MAX_CYCLES: after 30 cycles of a
    partially-delivered edge the st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
    [multimetreitor.ino]
2026-08-01 Fix two boot regressions from cfc6931: slow MQTT connect and false ICP trip records
    Both were found while auditing the recent commits and reproduced/fixed on the device.
    1) Slow MQTT connect after a reset (the reported symptom). NTP intermittently
    times out at boot (pool.ntp.org UDP is unreliable on this network), and
    setupMQTT() ran AFTER the up-to-30 s NTP wait, so on a slow-NTP boot the broker
    did not come up for ~30-43 s. Before cfc6931 NTP synced fast so this looked
    instant. Worse, a missed boot sync left the clock invalid until the 24 h resync.
    Fixes:
    - setup(): connect MQTT before NTP, so the queue comes up right after WiFi,
    independent of the NTP wait.
    - se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
    [multimetreitor.ino]
2026-08-02 ICP: don't open a forensic episode without a valid clock
    Since cfc6931, icpLogUpdate() runs during the boot waits. If an overload episode
    (> min(k,1.13)*In) opened before NTP had synced, it was stored with ts=0 (junk in
    the calibration log), and its close forced a blocking EEPROM.commit() mid-boot,
    which also perturbs the WiFi/NTP the boot is still bringing up.
    Only OPEN an episode when getCurrentEpoch() > 0. The thermal model and buzzer keep
    running during boot as before (cfc6931's intent); just the forensic record waits
    for the clock, so it always carries a real timestamp and never triggers a
    mid-boot flash write. An episode already open keeps tracking if the clock later
    blips (self-heal)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
    [multimetreitor.ino]
2026-08-02 ICP: realign de-energized cooling constant to tau1
    tau2 (de-energized cooling) defaulted to 1.5*tau1 with no catalogue
    basis -- trip curves only cover heating to trip. A first-order thermal
    body cools with the same time constant it heats with (tau = C/hA,
    independent of the internal source: the source sets the equilibrium,
    not the rate), so tau2 is realigned to tau1.
    DEF_ICP_COOLDOWN 576 -> 384 s. Bumped ICP_MODEL_MAGIC 0x71 -> 0x72 so
    deployed units adopt the new default on next boot; that migration only
    rewrites model params already at their defaults, leaving umbral,
    sensitivity and the forensic log untouched. Verified on the unit: only
    cooldown changed (576 -> 384), umbral stayed at 40%.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
2026-08-02 ICP: snap the danger bar to empty at 2% once it can no longer trip
    The bar descent is exponential, so its tail crawls through the single
    digits: from 1% it was still ~4-7 min to reach the old 0.5% snap floor,
    leaving a lingering 1% on the LCD/web long after the overload ended.
    Raise the snap-to-zero floor from 0.5% to 2% (2% already reads as empty),
    guarded by objetivo so it only fires when the load can no longer trip --
    a genuine small time-to-trip still settles on its real value instead of
    blinking to zero. Purely cosmetic: the buzzer clears at umbral-10 = 30%,
    far above the snap. Verified in simulation: the 1% tail goes from ~7 min
    to 0, and total time-to-empty drops ~9 min.
    [multimetreitor.ino]
2026-08-02 Web: add an overload-history viewer page
    The ICP forensic ring buffer was only reachable as raw JSON. Add a
    styled, bilingual (ES/EN via %LANG%), mobile-friendly HTML viewer that
    lists every recorded overload episode -- date/time, duration, peak
    current, max danger level (mini bar) and a red trip badge. The table is
    built client-side from the existing JSON endpoint, so the page touches
    neither the measurement path nor EEPROM (~6 KB flash, no RAM).
    Factor the token-expanding template streamer out of handleConfigForm
    into streamHtmlTemplate() and reuse it for both pages. Link added under
    the ICP section on the main config page.
2026-08-02 ICP log: severity-gated recording, trip-safe eviction, sortable viewer
    Two fixes so a burst of trivial spikes can no longer push a probable trip
    out of the 12-slot forensic ring:
    - Only record an episode if its peak danger reached ICP_LOG_MIN_NIVEL
    (10%); brief spikes that never built heat are dropped. Trips are logged
    from recoverICP and never pass through this gate.
    - When the ring is full, evict the OLDEST NON-TRIP episode instead of the
    strict-oldest; only if every slot is a trip is the oldest trip replaced.
    Slot order is thus no longer chronological, so consumers sort by the
    per-event ts.
    Viewer: table columns are click-to-sort (asc/desc, default date desc) and
    a disclaimer s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
    [multimetreitor.ino]
2026-08-02 Storage: mount LittleFS at boot; add /export backup and /fsinfo
    First step of the storage redesign that moves the growable data (forensic
    log, energy history, rules) out of the 4 KB EEPROM sector into the ~2 MB
    LittleFS partition (confirmed present: 4 MB flash chip, 2 MB FS, mounts).
    - Mount LittleFS in setupHardware() (formats on first use, non-fatal;
    the EEPROM config keeps working if it ever fails).
    - /export streams a versioned (schema 1) JSON backup of everything --
    settings, ICP model, energy history, rules, forensic log -- with raw
    numeric/enum values so a future /import round-trips exactly.
    - /fsinfo reports real flash size, OTA headroom and the FS partition.
    Read-only additi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
    [multimetreitor.ino]
2026-08-02 gitignore: ignore local device backups (/export snapshots)
2026-08-02 Storage: add /import to restore an /export backup (round-trip verified)
    Completes the backup/restore safety net before the LittleFS data
    migrations. POST a schema-1 backup to /import: every field is CLAMPED
    into range (never rejected or wiped on a bad value; missing fields keep
    their current value), the config magics are re-asserted and it saves.
    Applies live -- config is read each cycle, no reboot needed.
    Verified on-device: export -> import -> export is byte-identical.
    [multimetreitor.ino]
2026-08-02 ICP log: web-configurable record thresholds (level % and peak A)
    Replaces the fixed ICP_LOG_MIN_NIVEL constant with two settings editable
    from the web UI: record an episode when it reaches icpLogMinNivel % of
    danger OR its peak current exceeds icpLogMinAmp A. Defaults 1% / 30 A
    (was a fixed 10%). Trips are still always recorded regardless.
    Two config fields appended after the sensitivity block with their own
    magic guard (icpLogCfgMagic); nothing before shifts, so rules, energy
    history and ICP calibration keep their exact EEPROM offsets. ICP-section
    controls + tokens + i18n + save handler; exposed in the log JSON and the
    viewer note; carried in export/import (round-trip verified identical).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
    [multimetreitor.ino]
2026-08-02 ICP log: move the forensic log from the EEPROM ring to a LittleFS file
    The 12-slot EEPROM ring is replaced by an append-only icplog.bin (fixed
    10-byte records), so the log holds effectively unlimited episodes with no
    eviction. A soft cap (5000) rotates the oldest away; the JSON endpoint
    streams the most recent 1000. On first boot the file is seeded once from
    the EEPROM ring, so the existing episodes migrate across. No per-episode
    EEPROM write any more.
    The forensic log is no longer carried in export/import -- it is device
    telemetry in its own file, not config; the config round-trip stays
    byte-identical. Verified on-device: 12 episodes migrated and read back
    (probable-trip included); export/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
    [multimetreitor.ino]
2026-08-02 Energy: track daily consumption to a LittleFS file
    Adds per-day energy totals alongside the monthly history. A day boundary
    (checked every 10 min, and once at boot) snapshots the day's kWh -- how
    far the cumulative PZEM energy climbed during that day -- and appends an
    8-byte record (year, month, day, kWh) to a LittleFS file, append-only.
    Runs before the monthly reset so the last day of a month is captured with
    the pre-reset value; the day anchor re-zeros with the monthly counter.
    Daily state (currentDay, dayStartEnergy) is a magic-guarded config block,
    carried in export/import. The consumo endpoint now returns the recent
    daily series and today-so-far. Verified on-device: anchored to today w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
    [multimetreitor.ino]
2026-08-02 Web: pretty electricity-usage page (/consumos) with monthly + daily charts
    New /consumos page: KPI tiles (today, this month, daily average) plus
    monthly and daily bar charts, built client-side from the consumo JSON.
    Single series (kWh) -> one accent colour, current period highlighted,
    value shown in white inside the bar (readable on green/blue), bilingual,
    light/dark aware. The main-page consumption link now opens this page.
2026-08-02 Rules: move to LittleFS, raise limits to 16 rules / 8 conds / 4 actions
    Rules no longer live in the 4 KB EEPROM sector: the active table is a RAM
    array (g_rules) persisted to a LittleFS file, so the count is bounded by
    free heap, not the sector. Measured free heap (~26 KB) sized the limits
    at 16 rules x 8 conditions x 4 actions (name 32; action text buffers
    trimmed to 64/32/32 to fit) -- 2.7x the old 6/3/2.
    New Rule/RuleActionDef shapes for the active table; the old shapes kept
    as RuleLegacy in the EEPROM config ONLY to migrate the stored rules once
    (byte-identical, so the config layout and its static_asserts are
    unchanged -- energy history and calibration untouched). rulesLoad reads
    the fi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
    [multimetreitor.ino]
2026-08-02 Energy: move monthly history to LittleFS (unlimited months)
    Monthly totals now live in a LittleFS file (7-byte upsert records), so the
    history is no longer capped at 24 months -- it keeps every month for the
    life of the device. On first boot the file is seeded from the EEPROM ring;
    guardarMesActual, consumo, export and import all use the file now. The
    EEPROM monthlyHistory[24] stays as the migration source (vestigial), so
    the config layout and its static_asserts are unchanged.
    Verified on-device: 12 months migrated and served from the file, current
    month/day live, export/import round-trip identical.
    [multimetreitor.ino]
2026-08-02 ICP log: stop reboots being logged as trips; edit thresholds from the page
    The old heuristic flagged any reboot that came back within 3 min with a
    >=50% thermal state as a trip, so ordinary reboots (and today OTA flashes)
    logged bogus trips at 17-19 A. A real trip leaves the model at its ~100%
    trip point, needs a trip-capable current, and cuts power so the device
    COLD-boots. All three are now required: cold boot (reset reason power-on,
    not a soft ESP.restart), level >= 90%, current >= the recording threshold.
    A boot-time purge removes the false trips already stored (3 removed, 12
    real episodes kept).
    Also: the two record thresholds (danger % and peak A) are now editable on
    the log page via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
    [multimetreitor.ino]
2026-08-02 Web: separate Back/Refresh in the log & usage headers; log thresholds only on the log page
    The Back link and Refresh button now sit at opposite ends of a header row
    (title below) on both the ICP-log and usage pages, so Refresh cannot be
    tapped by accident when reaching for Back.
    The ICP-log record thresholds (level %, peak A) are removed from the main
    config form -- they are edited only on the log page now (via the small
    save endpoint added earlier).
2026-08-02 Energy: hourly consumption per day, drillable in the usage page
    Adds per-hour energy totals (LittleFS file, 9-byte records with
    year/month/day/hour), same anchor pattern as the daily tracking: the hour
    boundary (checked every minute now, and at boot) stores the finished
    hour kWh and re-zeros with the day/month on the monthly PZEM reset. Order
    is hour before day before month so each period is captured pre-reset.
    The usage page gains an hourly card: click any day bar (or pick a date)
    to drill into that day 24 hours via a new /json_hours?y=&m=&d= endpoint.
    The hourly anchor (currentHour, hourStartEnergy) is a magic-guarded config
    block, carried in export/import.
    Verified on-device: current ho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
    [multimetreitor.ino]
2026-08-02 EEPROM: clean AppConfig to schema v12 (drop vestigial arrays + magics)
    Phase 6 of the LittleFS storage redesign. The forensic log, rules and
    monthly/daily/hourly history all live in LittleFS now, so the EEPROM config
    no longer needs the vestigial icpLog[12] / monthlyHistory[24] / RuleLegacy
    rules[6] arrays or the scattered per-block magic guards. Collapse everything
    into a single magic+version (CONFIG_VERSION 11 -> 12).
    Deployed units migrate without a reset window: loadConfig() detects a v11
    config, reads the old byte-exact layout (kept as AppConfigV11) into a heap
    temporary, copies the retained fields honouring each old magic guard, then
    persists the clean v12 struct. static_asserts pin t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
    [multimetreitor.ino]
2026-08-03 Web: tabbed home (Alertas/Reglas/Consumo/Config) + config backup and history download
    - Split the home page into 4 top-level tabs. Alertas is the default and gets its
    own "Guardar alertas" button; Consumo embeds the usage page in an iframe (no Back
    button there); Config keeps the MQTT broker + LCD metrics and the 3 action buttons.
    Broker/alerts/LCD still live in one <form> so any save posts every field together
    (the handler treats a missing checkbox as off, so splitting forms would wipe state).
    - Rules editor: paginated one rule at a time (‹ / › with an n/m indicator), removed
    the standalone rule-count badge, justified the intro text, dropped the ⚡ from the tab.
    - Usage page: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
    [multimetreitor.ino]
2026-08-03 Config: device uptime + PZEM interval spinner; usage day auto-loads
    - Usage page: picking a day in the calendar loads its hours immediately
    (removed the extra "Ver" button; the date input drives it on change).
    - Config: moved the read interval to the top of the tab and renamed it
    "Intervalo de lectura PZEM". It is now a -/+ stepper (min 500 ms, 500 ms
    steps) that works on mobile too; lowered MIN_REFRESH_MS to 500 so the
    value actually persists instead of being clamped back to 1000 on save.
    - Config: replaced "counting energy since" with the device uptime since the
    last reboot (new /uptime endpoint + formatUptimeTo, refreshed every 15 s).
    - Config: the MQTT topics box now lists all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
    [multimetreitor.ino]
2026-08-05 Web: raise usage charts so h-scrollbar no longer covers x-axis labels
    The .chart containers use overflow-x:auto with flex-end alignment, so the
    overlay horizontal scrollbar was drawn over the bottom edge, hiding the
    x-axis labels. Reserve 16px of padding-bottom for the scrollbar and bump
    the height by the same amount to keep the bar area unchanged.
    [multimetreitor.ino]
2026-08-05 Web: Consumo tab — monthly-scoped daily chart + day-search box
    - Daily chart now shows only the current month's days, with the month
    name in the title.
    - Replaced the fixed hourly card with a day-search box: a date picker
    (defaulting to today) that shows the month total, that day's total
    and its hourly breakdown. Daily bars open their day here too.
    - Reused the existing drillDay identifier instead of a new name to
    dodge an arduino-cli ctags bug that injected prototypes into the
    CONSUMO_html raw string (compiled fine but broke the served JS).
    [multimetreitor.ino]
2026-08-06 Web: rule editor shows x/n counters for conditions and actions
    Each rule block now displays a used/max counter next to its title
    (CUANDO -> conditions /8, ENTONCES -> actions /4), turning amber when
    the limit is reached, so the remaining capacity is visible at a glance.
